SkyHao723/sweeper_chassis/README.md

# sweeper_chassis — 两驱差速清扫车底盘

STM32 底盘控制器 + FOC 驱动器 CAN 总线，上位机是 **RK3588**（ROS 2）。

**只有一个上位机，也只有一个固件。** 定位（卡尔曼滤波）在上位机做，
STM32 只管运动学、CAN 下发、看门狗、继电器和状态上报。

```
┌──────────────┐  USB 115200  ┌────────────────┐  CAN 500k  ┌──────────────┐
│    RK3588    │◄────────────►│     STM32      │◄──────────►│ FOC 驱动器 ×2 │
│  ROS2 + EKF  │  CH340       │  (底盘控制器)   │  PA11/PA12 │  1号 / 2号    │
└──────────────┘  PA9/PA10   └───┬────────┬───┘            └──────────────┘
                                 │        │
                            PB0 ┌▼┐   PB1 ┌▼┐
                                滚刷继电器  水泵继电器

                        PB10/PB11 ── 亚博 YbImu（软件 I2C）
                        PB9       ── 状态灯（上电后 2Hz 闪 = 主循环活着）
```

> 早期用 ESP32 网页遥控当临时上位机调试，**已废弃并从仓库移除**。
> STM32 上对应的 USART2 / 双口控制权仲裁 / 本地 EKF 也一并删掉了。

---

## 目录结构

```
sweeper_chassis/
├── README.md                             本文件
├── docs/
│   ├── wiring.md                         完整接线总表（先看这个）
│   ├── ros-integration.md                接入 ROS 2 的状态/启动/还缺什么
│   ├── ★ nav2-reference.md               **给做 Nav2 定位/导航的同事**：接口契约、
│   │                                     TF 树、实测精度、速度包线、故障模式
│   ├── chassis-serial-protocol.md        底盘串口协议说明（Wheeltec 那套，RK3588↔STM32）
│   ├── ★ foc-can-protocol.md             **FOC 驱动器 CAN 协议（STM32↔驱动器）**，
│   │                                     经厂家资料核对；模式/控制字/回码/上报/故障码
│   ├── pos-mode.md                       位置模式实验（在 pos-mode 分支上）
│   └── foc-driver-protocol-v1.2.pdf      FOC 驱动器通讯协议原始文档（厂家 PDF）
├── tools/
│   ├── decode_diag.py                    解码扩展诊断帧（查"轮子有没有劲"）
│   └── chassis_check.py                  底盘验收（命令值 vs /odom 实测）
└── firmware/
    └── stm32-chassis/                    STM32 底盘控制器（Keil MDK）
        ├── stm32-chassis.uvprojx         ← 唯一的工程
        ├── user/                         main.c / 中断 / 库配置
        ├── hardware/                     外设驱动（YbImu / OLED）
        ├── sys/                          Delay
        ├── lib/  start/  RTE/            ST 标准外设库 / CMSIS
        └── DebugConfig/
```

---

## 分工

| 谁 | 干什么 |
|---|---|
| **STM32** | 解析车体速度 `(vx, vy, wz)` → 差速逆解 → CAN 下发；轮速正解 + 读 IMU → 上报；看门狗；继电器 |
| **RK3588** | 真正的上位机：ROS 2 + EKF + 导航。接 STM32 的 USART1（PA9/PA10）|

**为什么 EKF 不在 STM32 上**：算力放在上位机，换车/改模型只改一处；
STM32 也不必为了滤波去背一堆浮点矩阵。本仓库历史上确实在 STM32 上跑过
EKF（配合网页画轨迹），ESP32 退场时一起删了，需要的话在 git 历史里找。

### ★ 两辆车共用这一份固件（编译期选车型）

底盘控制对两辆车**完全一样**，只有几何不同，所以用 `main.c` 里的一个宏区分：

| | 扫地机 sweeper | 洗地机 scrubber |
|---|---|---|
| 轮径 / 轮距 | 205 mm / 930 mm | **150 mm / 425 mm** |
| 轮周长 | 0.64403 m | 0.47124 m |
| `vx`→单轮RPM | `× 93.03` | `× 127.32` |
| `wz`→单轮RPM | `× 43.26` | `× 27.06` |
| 最大线速(200RPM) | 2.147 m/s | 1.571 m/s |
| PB9 心跳灯 | **2 Hz** | **5 Hz** |

```c
#define VEHICLE_SEL   VEHICLE_SCRUBBER   /* 默认值; 正常走 Keil target 选车型 */
```

**★ 选错是安全级错误**：把扫地机固件烧到洗地机上，转向增益变成
`930/425 = 2.19 倍`（转过头一倍多），而上报的 `body_wz` 只有真值的 `0.457 倍`
（EKF 严重低估转角 → 导航跑飞）。三道防线：

1. `VEHICLE_SEL` 没选或选错 → **直接 `#error` 编译失败**（不会悄悄用默认值）；
2. **PB9 心跳灯频率 = 车型**（2Hz 扫地机 / 5Hz 洗地机），上车前扫一眼；
3. 诊断帧 `f[30]` bit5-6 = 车型号，`decode_diag.py` 印成
   `车型=扫地机205/930` / `车型=洗地机150/425`。

⚠ 洗地机的 `MOTOR1_IS_LEFT` / `MOTOR1_INVERT` / `MOTOR2_INVERT` 是**接线属性**，
现在照抄扫地机的值，**第一次上电必须验证**：`decode_diag.py --drive 0.2 0`，
看两个轮子的"实际"是不是都为正。

---

## 快速开始

### 接线

**先读 [`docs/wiring.md`](docs/wiring.md)**，里面有全部引脚、电源要求和排错顺序。

最容易踩的三个坑：

1. **所有板子必须共地**（继电器不共地会持续嗡嗡响）
2. **串口 TX/RX 要交叉接**（TX 接对方的 RX）
3. **CAN 收发器选 3.3V 的**（SN65HVD230），TJA1050 是 5V 的，直连 PA11 有风险

### 编译烧录 STM32

工程：`firmware/stm32-chassis/stm32-chassis.uvprojx`

**★ 工程里有三个 target，第一个就是"选车型"—— 不用改源码：**

| Keil target | 车型 | 几何 | PB9 心跳灯 | 产出的 hex |
|---|---|---|---|---|
| `sweeper` | 扫地机 | 205 / 930 mm | **2 Hz** | `Objects/sweeper/sweeper.hex` |
| `scrubber` | 洗地机 | 150 / 425 mm | **5 Hz** | `Objects/scrubber/scrubber.hex` |

两个 target 的唯一差别就是编译宏 `-DVEHICLE_SEL=1/2`，源码是同一份。
**每个 target 有自己独立的输出目录**（`Objects/sweeper/` 与 `Objects/scrubber/`）——
这一点是必须的，理由见下面那个坑。

**烧录步骤：**

1. Keil 打开 `stm32-chassis.uvprojx`
2. 工具栏 target 下拉框选 **`sweeper`** 或 **`scrubber`**　← ★ 这一步就是在选车型
3. `F7` 编译（产物落在 `Objects/<车型>/<车型>.hex`，**路径和文件名都自带车型**）
4. ST-Link (SWD) 接上，`F8` Download
5. 烧完**看一眼 PB9 的灯**：2 Hz = 扫地机，5 Hz = 洗地机，对上了再上车
6. 上位机起来后再核一次（最硬的证据）：`python tools/decode_diag.py --port ...`
   看 **车型=** 那一栏是不是 `扫地机205/930`

SWD 占用 PA13/PA14，和串口不冲突。目前 Code ≈ 12972 B / RO 268 / RW 160，
两条 target 都是 **0 Error 0 Warning**。

> ### ★★ 2026-10-12 的坑：烧错固件（已修，务必知道）
>
> **症状**：target 明明选的是 `sweeper`，但 PB9 **灯闪得很快**（= 5 Hz），
> 同事反馈**导航不对**。Keil 编译日志是干净的 0 Error 0 Warning，完全看不出来。
>
> **根因**：加双 target 时是用文本复制 `<Target>` 块做的，把原来的
> `.\Objects\` 一起复制了过去 —— **两个 target 共用同一个输出目录**，
> 而 `.o` 是按**源文件名**命名的，于是**全工程只有一个 `main.o`**。
> 于是这个序列就会出错：
>
> ```
> 选 scrubber -> F7 编译   → main.o 是【洗地机】版
> 选 sweeper  -> F7 增量编译 → Keil 发现 main.c 比 main.o 旧, 不重编
>                            → 直接把洗地机的 main.o 链成 sweeper.hex
> ```
>
> **实测证据**：当时 `Objects/main.o` 时间戳 14:10:45（洗地机那次编译），
> 而 `Objects/sweeper.axf` 是 14:19:17（晚了 9 分钟，中间没重编），
> 且 `sweeper.hex` 与 `scrubber.hex` **SHA256 完全相同**。
> 也就是说 **`sweeper.hex` 里装的确实是洗地机固件** —— 灯没说谎。
>
> **后果**：洗地机的几何（150/425）装到扫地机上 → 转向被放大/缩小 2.19 倍、
> 里程计距离少报 27%（详见下面"两辆车共用这一份固件"那节）→ **导航必然跑飞**。
>
> **修法**：每个 target 一个独立输出目录
> （`Objects/sweeper/` 与 `Objects/scrubber/`，`Listings/` 同理），
> 这样 `.o` 不可能互相覆盖。`tools/add_keil_targets.py` 已同步修好，
> 以后加车型不会再犯。
>
> **教训**：
> 1. **"两个 hex 不一样"不等于"两个 hex 都对"** —— 我上次就是这么验的，
>    当时刚跑完 Rebuild 所以确实对，但**没验证"哪个是哪个"**。
>    真正的验证要在 hex 里搜**车型特有的常量**（扫地机周长 0.644026 / 轮距 0.930，
>    洗地机 0.471239 / 0.425）。
> 2. **换 target 之后如果不用 Rebuild，就一定要看灯**。现在结构上修好了，
>    但"看灯复核"这个习惯值得留着 —— 它是唯一不依赖工具链的行为。

> ⚠ 改双 target **之前**那个 `Objects/stm32-chassis.hex` 已经删掉了 ——
> 它的文件名不带车型，分不清是哪辆车，别再烧它。
>
> `VEHICLE_SEL` 没定义时会落到 `main.c` 里的默认值（现在是洗地机），
> 但**别依赖这个默认值**：命令行直接编、或者以后新加 target 忘了带宏，就会落到
> 它上面。所以正常流程一律走"选 target"。
>
> 命令行编译要**显式带 target**：`UV4 -r stm32-chassis.uvprojx -t scrubber -o log`。
> 不带 `-t` 编的是列表里**第一个**（现在是 `sweeper`），不是源码默认值 —— 别混。
>
> 以后要再加车型（第三个底盘）：`python tools/add_keil_targets.py <uvprojx>`
> （幂等，已经加过会拒绝并提示；会自动给新 target 设独立输出目录）。

---

## 底盘参数

在 `firmware/stm32-chassis/user/main.c` 顶部，**换车必须重新标定**：

```c
#define WHEEL_DIAMETER_MM   205.0f   /* 车轮直径 */
#define TRACK_WIDTH_MM      930.0f   /* 左右轮触地间距 */
#define MAX_RPM             200      /* 单轮转速上限 */

#define MOTOR1_IS_LEFT      1        /* 1号电机在左侧 */
#define MOTOR1_INVERT       0        /* 某个轮子转向相反时改成 1 */
#define MOTOR2_INVERT       1        /* 实测 2 号电机正方向是反的 */

#define ACCEL_STEP_MS       0        /* 加速间隔 ms/1RPM, 0=阶跃, 见下 */
#define DECEL_STEP_MS       0        /* 减速间隔, 停车安全优先, 保持 0 */
```

方向不对照着 `docs/wiring.md` 的校准表改，别硬调混控逻辑。

### 加减速斜坡：现在是 0（阶跃），别再凭直觉加

命令帧里的 `DATA4/DATA5` 是**加减速间隔**，单位是「每变化 1 RPM 花多少毫秒」，
范围 0~100，0 = 阶跃。

**曾经改成 3**（想让起步柔和、少顶过流保护），但一直没做 A/B。后来补上对比，
同一条 0.30 m/s 直线：

| | 斜坡=3 | 斜坡=0（现在）|
|---|---|---|
| 稳态速度 | 68%~137% 乱跑 | **86%**（全程=稳态）|
| 到 80% 速度 | 0.15~0.80 s | 0.40 s |
| 直线漂移 | ~20°/m | **−5.4°/m**（1.54 m 偏 8.3°）|

**漂移改善约 4 倍。** 机理猜测：斜坡让驱动器的设定值缓慢爬升，而驱动器速度环
本身就在低频振荡（空载实测：目标 18 RPM 时实际在 0~22 之间来回冲），设定值
慢慢追会让两者互相激励、振得更厉害；改回阶跃后环反而更容易稳住。

**想再加斜坡之前先做 A/B，别凭直觉**；也别指望它改善准确度 —— 它本来是为了柔顺。
减速也保持 0：要停就立刻停，停车安全优先。

> 起步迟钝的**真正**原因不是斜坡，是轮胎刮擦/静摩擦（见下面"轮速外环修正"）。
> 斜坡只会雪上加霜。

### 轮速外环修正（trim）

STM32 原来是**纯开环**：算完目标轮速直接发给驱动器，从不回读实际转速。所以
驱动器没做到位它也不知道。实测（2026-09，原地转，车在实地）：

| 命令 wz | 单轮目标 | 第 0 秒 | 第 1 秒 | 第 2 秒 | 稳态 | 四秒总角度 |
|---|---|---|---|---|---|---|
| 0.30 | 13 RPM | 5% | 15% | 89% | 85% | 49% |
| 0.50 | 22 RPM | 1% | 29% | 20% | 115% | 41% |
| 0.70 | 30 RPM | 10% | 86% | 121% | 106% | 81% |
| 1.00 | **43 RPM** | **26%** | 106% | 100% | 96% | 82% |

**即使目标高达 43 RPM，第 0 秒也只有 26%** —— 而直线运动 0.07 秒就到 80%。
同一个轮速区间差这么多，说明这**不是**驱动器低速死区，而是**原地转要克服轮胎
刮擦/静摩擦**：轮子是真的没转（不是空转打滑），所以把指令顶上去它就会转。

#### 第一版：纯积分 + 绝对限幅（已废弃，别重犯）

第一版是"纯积分 + 绝对限幅 ±30 RPM + `TRIM_KI=1.5`"。四秒总角度确实从
41%~82% 提到了 85%~98%，稳态也从 115% 回到 101% —— **但形状和安全性都不合格**：

- **绝对限幅在小名义值下会把指令顶成反向。** 原地转 `wz=0.30` 的名义轮速只有
  13 RPM，而修正量能到 -30，于是 `指令 = 13-30 = -17`，**轮子反转**。干净重测的
  逐秒数据 `0.025 / 0.585 / 0.573 / -0.001` 里第 3 秒直接归零，就是它。
  一个"修正"把自己修成了故障。
- **`TRIM_KI=1.5` 太快，和驱动器那个环组成了慢速极限环。** `wz=1.00` 的逐秒是
  `0.386 / 1.746 / 0.867 / 0.529`：第 1 秒过冲 175%，然后一路衰减下去。
  积分增益 × 被控对象滞后 > 1 就会这样。
- 第一版注释里写的"输出永远落在普通全速命令能到的范围内"是**错的**：
  `MAX_RPM` 是 200，而 ±30 的绝对限幅在名义值 13 时已经把指令推到 2~3 倍了。

#### 第二版：慢积分 + 比例限幅 + 定时助推（已废弃）

```c
#define TRIM_KI            0.6f     /* 慢积分, 只修稳态偏差 */
#define TRIM_UP_K          0.5f     /* 正向最多 +50% 名义值 */
#define TRIM_DOWN_K        0.5f     /* 反向最多 -50% 名义值 -> 永不反转 */
#define KICK_RPM           12.0f    /* 起步助推幅度, 固定值 */
#define KICK_MS            400      /* 助推的硬上限时长 */
#define KICK_RELEASE_K     0.6f     /* 轮速达到名义值的这个比例就撤掉助推 */
```

三条改动逐条对症：

1. **限幅改成按名义值的比例**，不用绝对值 —— 于是指令永远落在 `[0.5, 1.5]` 倍
   名义值之内，**方向永远不变**。反转从机制上被消除。
2. **`TRIM_KI` 降到 0.6**，让它只修稳态偏差，不去和驱动器那个环抢动态。
3. **起步助推单独做。** 突破静摩擦需要的是"立刻给力"，而积分天生要"等误差攒
   起来"；把积分调到能立刻给力，它就会在轮子追上来之后迟迟不回，那正是第一版的
   过冲。两件事分开：**积分慢而稳只管稳态，助推开环/有界只管起步这一下**
   —— 开环所以不构成第二个反馈回路，也就不会振。

第二版的助推判据是"轮速一到名义值的 60% 就撤"（`KICK_RELEASE_K`），比第一版的
纯定时好，但仍然**按名义值的比例**判定 —— 这就是它后来又出问题的原因（见第四版）。

#### 第三版：加线性带（已并入第四版）

第二版实测逐帧抓到：**积分在起步暂态里把自己顶到限幅**，然后和驱动器的 PI 组成
一个 **0.25 Hz 的极限环** —— `目标-理论` 那一列直接看得到:
`+7 -> +13(贴住限幅) -> +12 -> +9 -> +5 -> 0`，来回摆 ±14 RPM，周期 4~5 秒，
和速度振荡测出来的 0.25 Hz 完全吻合。机制：起步时轮子没转 → 误差巨大 → 积分顶到
+50% → 驱动器本来就过冲 → 实际冲到 186% → 误差大幅反向 → 积分慢慢退回甚至摆到
-50% → 车慢下来 → 积分又上去。

所以加了**线性带**：**误差超过 `TRIM_LIN_BAND_RPM` 就不积分**。起步/被刮擦卡住时
误差是 20~28 RPM，落在带外 → 完全不积分 → 从根上消掉那个 windup。同时 `TRIM_KI`
0.6→0.3、权限 ±50%→±20%。改完后 `目标-理论` 平在 ±1 RPM。

#### 第四版（现在）：绝对转速判据 + 按缺口给量 + 给不动就加力

实车又报了两个症状 —— **它们是同一个根因的两端**：

| 症状 | 根因 |
|---|---|
| 发小一点的转向命令，车愣在原地 | 助推是 **400 ms 一次性定时**，超时就撤，且目标没回零就**不会重新武装** |
| 转向太敏感 | 助推是**固定 +12 RPM 加性**，原地转时等效 **+0.28 rad/s**；每次起步都给满 400 ms |

```c
#define TRIM_ENABLE        1
#define TRIM_KI            0.3f     /* 慢积分, 只修稳态偏差 */
#define TRIM_UP_K          0.2f     /* 正向最多 +20% 名义值 */
#define TRIM_DOWN_K        0.2f     /* 反向最多 -20% 名义值 -> 永不反转 */
#define TRIM_MAX_RPM       20.0f    /* 绝对上限, 防高名义值下修正量过大 */
#define TRIM_LIN_BAND_RPM  5.0f     /* 误差超过它就不积分 */
#define TRIM_DEADBAND_RPM  0.5f     /* 目标小于它 = 不该动, 全部清零 */

#define KICK_BASE_RPM      15.0f    /* 起步门槛估计: 助推把命令补到这个轮速 */
#define KICK_MAX_RPM       20.0f    /* 助推上限(含逐级加力) */
#define KICK_STEP_RPM      4.0f     /* 给不动 -> 每 KICK_STEP_MS 再加这么多 */
#define KICK_STEP_MS       200
#define KICK_STILL_RPM     2.0f     /* |实际| 低于它 = 还是静止 */
#define KICK_MOVING_RPM    6.0f     /* |实际| 高于它 = 转起来了, 撤助推 */
#define KICK_MAX_MS        3000     /* 加到上限还不动, 先给这么久就歇一下(防卡死) */
#define KICK_COOL_MS       2000     /* 歇多久再试(★ 不能永久放弃, 见下) */
```

三条：

1. **判"动没动"用绝对转速**（`KICK_STILL_RPM` / `KICK_MOVING_RPM`），不看名义值的
   比例。要破的是静摩擦，"轮子转没转"跟命令多大无关。副产物：判据与命令大小
   无关，大命令上不会过度助推，也不会在阈值附近抖。
2. **按缺口给量**：`助推 = clamp(KICK_BASE_RPM - 最小|名义轮速|, 0, KICK_MAX_RPM)`。
   名义值本身就超过起步门槛 → 助推 = 0 → **正常行驶完全没有助推**：
   直行 0.30 m/s（名义 27.9 RPM）助推 0，原地转 `wz ≥ 0.35` 助推 0。
   小命令则被**恰好**补到起步门槛，不多给。
3. **给不动就逐级加力**：补到 15 还不动，每 200 ms 再加 4 RPM，到 20 封顶。
   这样"到底要多大劲才动得起来"是**实测量出来的**，`KICK_BASE_RPM` 只是起点。

为什么固定 +12 RPM 对偏航的影响被严重低估 —— 助推是**按各自名义方向**加的
（右轮 +12、左轮 -12），换算成偏航角速率（`每轮名义 RPM = wz × 43.26`）：

```
Δwz = 助推 / 43.26        12 / 43.26 = 0.28 rad/s
```

也就是原地转**起步那段时间真实 wz 比命令值高 0.28 rad/s**：`wz=0.30` 的实际是
0.58（192%），`wz=0.50` 的实际是 0.78（155%）。**这解释了为什么稳态测出来是
100~102% 却仍然手感"贼"** —— 助推是暂态，稳态数据里看不到它，人每次起步都能感到。

**助推对 `(vx, wz)` 的影响取决于两轮名义值同号还是异号**（很容易想错）：

| 情况 | 助推的效果 |
|---|---|
| **原地转**（`vx=0`，两轮名义值异号） | 两轮被往相反方向推 → 差分增加值 `2×助推` → **偏航被抬高**，`Δwz = 助推/43.26` |
| **边走边转**（`vx` 够大，两轮名义值同号） | 两轮加的是**同一个方向** → 差分**不变** → **偏航一点没变**，只是车临时多往前冲一点 |

所以"转向变敏感"只可能来自**原地转**；边走边转时 `wz` 是诚实的。第四版把
`|wz| ≥ 0.35` 的助推压到 0，正好把原地转这个来源切掉。

**助推必须是两轮共享的一次判决**（`Boost_Decide()`）。若按各自转速独立判决，
转弯/起步时总有一个轮子先转起来、先撤掉助推，另一个还在加 → 两轮指令瞬间差
十几 RPM → **起步时车会歪一下**。旧版是固定 400 ms 定时，两边同时给同时撤，
天然对称；改成"没转起来就给"之后必须显式做成共享，否则等于凭空引入一个偏航源。

**安全性**（按"绝不引入新的失控模式"设计）：

1. 指令永远落在 `[1-TRIM_DOWN_K, 1+TRIM_UP_K]` 倍名义值之内（助推另加，且助推
   有上限 `KICK_MAX_RPM`），**方向不变**。
2. **目标为 0 时 `Trim_Apply` / `Boost_Decide` 恒定返回 0**，修正和助推一起清零、
   不留历史 —— 外环**不可能**在主机下令停车的时候把车带着走。这是敢上车的底线。
3. 最后还有一条独立的保险：名义为正就保证输出 ≥ 0，反之亦然。即使上面的限幅
   哪天被人改错，这条也能兜住。
4. 驱动器回码不新鲜时不积分、只保持，助推也**倾向于不撤**（没观测就不做结论）。
5. **里程计不受影响**：`Wheel_Update()` 用的仍是驱动器回传的实际转速，外环只改
   下发值，所以上报给上位机的轮速依然诚实。
6. 积分用的是**真实周期**（从 `g_tick_ms` 算），不是标称的 20 ms —— 否则
   `TRIM_KI` 的实际含义会随主循环负载漂移，参数就没法标定了。
7. **防卡死**：助推加到上限还不动满 `KICK_MAX_MS` 就**歇 `KICK_COOL_MS`**（3 s 给 /
   2 s 歇的占空比），免得一直顶着烤电机和驱动器；同时把诊断帧 `flags` **bit7**
   置位（锁存到目标归零）。★ 这里**刻意不做成"永久放弃"** —— 第一版的毛病就是
   "超时之后再也不给"，于是小命令永远愣在原地；万一这台车破静摩擦真的需要比
   `KICK_MAX_RPM` 更大的劲，一次放弃就等于把那个故障原样造回来。

**怎么看它在不在干活**：诊断帧里上报的"目标"是**含修正和助推的最终命令**。用
`--drive` 时脚本知道主机下发的理论目标，会自动把差值还原出来：

```bash
# ★ 跑之前必须先暂停看门狗! 否则它会把 ROS 节点反复拉回来抢串口（见"已知的坑"）
touch /tmp/chassis_watchdog.pause
# 然后停掉 ROS 底盘栈 (Ctrl-C), 再:
python3 tools/decode_diag.py -p /dev/wheeltec_controller --drive 0 0.5
# 输出里会多出一段:   目标-理论+18/+25(含助推)
rm /tmp/chassis_watchdog.pause     # 调完一定要删!
```

> ⚠️ 那个"目标-理论"是 **积分修正 + 助推** 的合计，不是积分本身。实测被它骗过
> 一次：看到 `+13` 以为积分已经顶到比例限幅了，其实其中 12 是助推、积分只剩 1。
> **诊断帧没有空余字节放助推量**，所以固件在 `flags` 上给了两个位：
> **bit6 = 这一帧正在给助推**，**bit7 = 加到上限还不转**。`decode_diag.py` 会把
> 它们翻成中文打出来。

**调参**：起步还是慢/还是愣 → 加 `KICK_BASE_RPM`（每次 +3 RPM 试）。
嫌起步窜 → 减 `KICK_BASE_RPM`。看到轮速以 0.1~0.2 Hz 慢速来回摆 → 降 `TRIM_KI`。
想 A/B 就把 `TRIM_ENABLE` 改成 0 重新编译（两条路径都能 0 Error 0 Warning 通过）。

**这次改动怎么验证**（★ 未上车，先按这个顺序做）：

```bash
# 0) 暂停看门狗, 停掉 ROS 底盘栈
touch /tmp/chassis_watchdog.pause

# 1) 小命令不再愣住: wz=0.25 原地转, 看"实际"能不能离开 0
python3 tools/decode_diag.py -p /dev/wheeltec_controller --drive 0 0.25
#    期望: flags 出现"起步助推中", 实际轮速 1~2 秒内起来, 然后助推自动消失

# 2) 正常转弯不再窜: wz=0.5 原地转, 期望 flags **不出现**"起步助推中"
python3 tools/turn_truth.py 0.5
#    期望: 对 IMU 真值 100% 左右, 且起步段不再明显超前

# 3) 直行起步: 助推应为 0(名义 27.9 RPM > 门槛 15), 起步过冲应比旧版小
python3 tools/straight_quality.py 0.30 10
#    ★ 这是最需要确认的一条: 旧版靠 +12 RPM 起步, 现在直行不给助推了,
#      万一 27.9 RPM 自己起不来, 就会看到"命令有、实际 0" -> 那就把
#      KICK_BASE_RPM 调大(比如 20), 让它对直行也稍微补一点

# 4) 收工
rm /tmp/chassis_watchdog.pause
```

#### 还没解决：直线精度的锅不在外环，在驱动器自己的速度环

> 下面这组数据是**第一版/第二版助推时代**抓的（那时助推固定 +12 RPM，所以
> "目标 +35" = 名义 27.9 + 助推 7）。第四版的助推在直行上已经是 0，但驱动器
> 速度环自己那个极限环是**下面这个结论**，和外环无关，仍然需要重测确认。

用 `decode_diag --drive 0.30 0` 逐帧看（这是唯一能看到外环内部的途径）：

```
目标 +35  实际  +0   +7.80A     ← 目标是名义值 27.9 + 助推
目标 +36  实际 +62   +5.00A     ← 实际跳到名义值的 2.2 倍
目标 +41  实际 +23   +8.00A
目标 +31  实际 +52   +1.60A
```

**目标 27.9 RPM，实际在 0 ↔ 71 RPM 之间暴力来回冲，电流 7~11A。**

而外环自己只贡献几个 RPM。所以**直线精度的根因是驱动器速度环自己的极限环**，
这一层外环够不着 —— 外环只能改"要它转多快"，改不了"它内部怎么调"。

这也解释了 `chassis_check.py` 报的"全程 31% 而稳态 106%"：不是自相矛盾，是
速度在剧烈振荡，而"稳态"只取尾部 40%，恰好采到了波峰。

**能治它的只有两条路**（也就是本文档早先那句"要么找厂家调，要么在 STM32 上用
扭矩模式自己做速度环"）：
1. 找厂家调 / 关掉驱动器内部的速度环参数 —— 协议不暴露这些寄存器。
   **2026-10-11 已用厂家资料核实过，确认没有任何参数读写通路**
   （CAN/串口/BLE 都没有，见 [`docs/foc-can-protocol.md`](docs/foc-can-protocol.md) §6），
   所以这条路**只能找厂家**，我们调不了。
2. **STM32 切扭矩模式，自己做速度环。** FOC 的扭矩指令是平滑的，这样也不再有
   第二个环跟它打架。代价是安全性模型变了：**扭矩模式下"指令卡住"= 持续加速**
   （速度模式只是匀速跑），必须配电流限幅，并依赖 IWDG + 上电刹车帧兜底。
   ★ **这条路现在是通的**：核实确认**扭矩模式 `0x04` 确实存在**
   （单位 A、量程 ±10.0 A、值 = 电流×10），我们之前"0x04 不存在"的判断是**错的** ——
   详情与出处见 [`docs/foc-can-protocol.md`](docs/foc-can-protocol.md) §2.1 与 §7。
   ⚠️ 但它在**我们这台**驱动器上能否动作仍是 ❓ 未实测。

---

## 状态上报

STM32 每 50ms 往 USART1 发**两帧**：

| 帧 | 长度 | 内容 |
|---|---|---|
| 主遥测帧 `0x7B` | 24 字节 | 标准 Wheeltec 格式：车体 vx/vy/wz、IMU 六轴、电池电压 |
| 扩展诊断帧 `0x7E` | 36 字节 | 本工程自定义：**每路驱动器的最终命令/实际转速、输出电流、故障码、模式** |

帧顺序**不能反**：主遥测在前、诊断帧紧跟，诊断帧永远夹在两个 24 字节帧之间。

**为什么厂商节点不会被这一帧干扰**：它的入帧条件是「上一字节是帧尾 `0x7D`
（或 `0x7F`）、本字节是帧头 `0x7B`」。诊断帧自己的帧头是 `0x7E`、帧尾是 `0x7D`，
所以它会被整帧跳过，紧接着的那个 `0x7B` 恰好满足入帧条件 —— 24 字节帧一帧都不丢，
**厂商侧不需要任何改动**。

### 怎么读诊断帧

```bash
# 串口是独占的: 先把厂商底盘节点停掉 (Ctrl-C), 看完再起回来
python3 tools/decode_diag.py -p /dev/wheeltec_controller

# 只看有问题的轮子
python3 tools/decode_diag.py -p /dev/wheeltec_controller --only-problems
```

输出长这样：

```
seq=3   vx= +145 wz=   +0 | 1号 目标 +28 实际  +0  +0.02A 速度   正常   | 2号 目标 +28 实际 +28  +1.75A 速度   正常
    !! 1号 命令 +28 RPM 但实际 +0 RPM 且电流仅 0.02A -> 驱动器没给力(查故障码/使能/接线)
```

**输出电流是判断「这个轮子到底有没有劲」唯一的客观指标**，它把两种情况分开了：

| 现象 | 含义 |
|---|---|
| 目标有转速、实际不转、**电流≈0** | 驱动器根本没给力 → 查故障码 / 使能 / 接线 |
| 目标有转速、实际不转、**电流很大** | 给了力但被堵住或拖住 → 查机械卡滞 / 负载 |
| 目标有转速、实际也有、电流正常 | 正常 |

故障码表来自 `docs/foc-driver-protocol-v1.2.pdf` 第 11 页，脚本里已经内置：

```
0 正常   1 驱动器故障   5 过流   6 过压   7 欠压   8 过温
23/24 电机2/1 霍尔故障   25/26 电机2/1 堵转
27 UART 故障   28 RS485 故障   29 CAN 故障
```

> **7 = 欠压值得特别注意**：车上电池实测 26.6V 左右，而电机是 36V 额定的，
> 加速时电池一压降就可能触发欠压保护，表现正是「这个轮子突然没劲了」。

### 台架复验（轮子必须悬空）

串口是独占的，所以「下令」和「看数据」不能分成两个程序。`--drive` 让脚本
一边下发命令一边解码：

```bash
# 1. 停掉厂商底盘节点 (Ctrl-C)，否则串口抢不到
# 2. 轮子架空，按顺序跑这几条，每条都用 Ctrl-C 或 --seconds 结束
python3 tools/decode_diag.py -p /dev/wheeltec_controller --drive 0.10 0 --seconds 3
python3 tools/decode_diag.py -p /dev/wheeltec_controller --drive 0 0.30 --seconds 3
python3 tools/decode_diag.py -p /dev/wheeltec_controller --drive 0 -0.30 --seconds 3
```

看什么：

| 现象 | 结论 |
|---|---|
| 两个轮子都转、电流都是正数、方向对 | 正常，可以上地面 |
| 某一路 `实际` 始终 0 且 `故障` 非 0 | 驱动器报故障，按故障码查 |
| 某一路 `实际` 始终 0、`故障`=0、**电流≈0** | 驱动器没给力 → 先查驱动器使能、功率电、CAN 接线（**和继电器无关**，继电器只管滚刷/水泵）|
| 某一路 `实际` 始终 0、`故障`=0、**电流很大** | 给了力被堵住 → 查机械卡滞 |
| 原地转向时两轮 `目标` 一正一负 | **正常**，差速车原地转就是这样 |

脚本退出时会自动连发一串零速把车按住。STM32 另有 800ms 看门狗兜底。

### ★ 指令保活：不发就会停（和"记住最后一条命令"的车不一样）

**本车不会保持最后一条命令。** 800 ms 收不到**速度帧**，STM32 就把目标归零并刹车，
而且**锁存**（诊断帧 `flags` bit1 `看门狗停车`，下一条速度帧才解除）。代码在
`main.c` 的 `LINK_TIMEOUT_MS` 那一段。

所以：**发一条 `vx=0.5` 然后不再发 → 车走约 0.8 秒就停**，不会一直走。
以前那种"发一次就一直走"的车是底盘记住了最后一条命令，那是另一套设计（也更危险：
上位机进程死了车还在跑）。

配套推论：**任何发布 `/cmd_vel` 的节点都必须持续发，频率要 ≥ 2 Hz。**
Nav2 的 `controller_server` 按控制频率发（默认 20 Hz），没问题；
但自己写的脚本发一条就退出，车只会动 0.8 秒。

**零速命令是"一等公民"，不会被当成没命令。** 收到 `vx=0, wz=0` 的速度帧时，
STM32 会：喂运动看门狗、**把 `failsafe_latched`（`flags` bit1）清掉**、然后按
20 ms 周期发 `CTRL_BRAKE` 刹车帧。所以：

| | 收到零速帧 | 静默 800 ms |
|---|---|---|
| 电机动作 | 刹车帧 @20 Hz | 刹车帧 @20 Hz |
| `flags` bit1 看门狗停车 | **清 0** | **置 1 并锁存** |
| 滚刷/水泵 | 保持 | 断开 |

也就是说"显式停车"和"上位机掉线"**在电机上一样、在语义上完全不同**，
而且**发零速帧还能把上一次的锁存解除掉**（想让车老实停住，就持续发零速）。
单个零速帧长这样（BCC 恰好等于帧头）：

```
7B 00 00 00 00 00 00 00 00 7B 7D
```

> ⚠️ 但有个陷阱：如果 `/chassis_security` 或 `/robot_recharge_flag` 被置成非 0，
> 厂商节点会把这两个标志塞进每条速度帧的 `f[1]`/`f[2]`，STM32 就会把**所有**
> 速度帧（包括零速）当成功能帧丢掉 —— 表现为 `/cmd_vel` 在发、遥测正常、**车
> 完全不动**，而且 800 ms 后 `flags` bit1 会置位。详见
> [chassis-serial-protocol.md 6.3.1](docs/chassis-serial-protocol.md)。

**★ 用键盘 teleop 会因此变得很难开，这是实测过的坑：**

车上装的 `teleop_twist_keyboard` 2.4.1 在 Linux 下是**阻塞**读一个字符
（`sys.stdin.read(1)`，**没有超时**），而且**每按一次键只发一条 Twist**：

- 默认步长 `speed=0.5 m/s`、`turn=1.0 rad/s`，是**绝对值**不是增量。
- 按一次 `i` = **发一条** 0.5 m/s 的消息 → 只够走 0.8 秒 → 看门狗把车停住。
- 想连续走必须**按住键**（靠终端按键重复）。一松手，0.8 秒后车就停。
- 而 0.5 m/s 正好落在**实测不该用的区间**（实测 134% → 实际约 0.67 m/s）。

一边要不停按键、一边每条命令还都超出工作包线，手感自然"非常不好控制"。
**换成网页遥操就好**（见下一节）：它以 20 Hz 持续发布同一条命令，
所以手感回到"按住就一直走"，同时真正的死手还在（进程被杀 → 0.8 秒 → 停）。

非要用键盘的话，把步长调下来并按住键：

```bash
ros2 run teleop_twist_keyboard teleop_twist_keyboard \
  --ros-args -p speed:=0.1 -p turn:=0.3
```

---

## 数据网页 + 运动控制（局域网直接开）

车上的 RK3588 跑了一个网页，浏览器打开即可：

```
http://192.168.5.17:8080
```

```bash
# 它是个 systemd 服务, 已 enable, 开机自启
systemctl status chassis-web
sudo systemctl restart chassis-web
journalctl -u chassis-web -f

# 想只要监视、绝对不给任何发速度的可能:
#   改 /etc/systemd/system/chassis-web.service 的 ExecStart 加 --no-control
# 想安全地改控制代码(逻辑全跑但车不动): 加 --dry-run (速度发到 /cmd_vel_dryrun)
```

**首页主角是两个数**，因为这一路查下来真正有信息量的就这两个：

| | 含义 | 为什么要摆在最显眼处 |
|---|---|---|
| **达成率** | `/odom` 实测车体速度 ÷ `/cmd_vel` 命令速度 | 直接回答"车有没有照我说的做"。原地转只到 41%、直线的锅在驱动器内环 —— 都是它先露出来的 |
| **航向差（相对打开页面时）** | (Δ EKF 偏航) − (Δ 轮速偏航) | 回答"EKF 到底有没有在纠偏"。两者几乎重合 = IMU 没起作用 |

其余：命令/实测/融合三路速度对比表、IMU 六轴、电池、6 路超声波、各话题频率与
"最后收到多久"（看 CH340 掉线很有用）、前进/转向滚动曲线、俯视轨迹图。

### 运动控制是照"绝不允许'浏览器不发了车还在走'"设计的

这台车因为控制层的 bug 真失控过一次，而网页遥控最容易出的就是那一类问题
（切标签页、WiFi 断、手指离开、笔记本合盖）。所以：

**三层兜底，任何一层单独失效车都会停：**

| 层 | 触发 | 动作 |
|---|---|---|
| 浏览器 | 松手 / 鼠标移出 / 松开按键 / 切标签页 / 失焦 / 空格 / 急停键 | 立刻 POST 停车 |
| **服务端** | 浏览器 **0.5 s** 没发心跳 | 立刻**补发 8 帧零速**(≈0.4 s) 再闭嘴 |
| STM32 | 0.8 s 收不到速度帧 | 运动看门狗停车 |

> 中间那层的"**补发**"是必须的，不是保险起见：如果只是沉默，STM32 要等它自己
> 800 ms 看门狗才停 —— **那 0.8 秒车还在按最后一条命令走**。这是死手设计里最容易
> 漏的一条缝，已用 `--dry-run` 实测验证过（见下面"怎么验的"）。

**另外四条同样是刻意的：**

1. **必须显式"使能"**（默认禁止运动），丢失心跳不会自动使能。
2. **限幅在服务端做，不信浏览器。** 默认 `vx ≤ 0.35 m/s`、`wz ≤ 1.2 rad/s`
   （实测工作包线 0.25~0.35 最好，>0.4 会超速）。界面上改不了上限。
3. **看不到车就不许动。** `/odom` 超过 1 s 没更新一律停车 —— 底盘链路断了
   （CH340 掉线那种）时你的操作没有反馈，那就不该动。
4. **不主动霸占 `/cmd_vel`。** 只在"使能 + 心跳新鲜"时发布；松开补几帧就闭嘴。
   否则本页 20 Hz 的零速会和 Nav2 抢 `/cmd_vel`，车会一抖一抖。页面还会显示
   `/cmd_vel` 上有没有**别的**发布者并报警。

**急停和松手是两回事**：松手/松键只是**停**（保持使能，不然开车要一直重新点）；
急停键/空格/切标签页是**停 + 撤销使能**。

### 一个刻意的取舍

**只用标准库，不装任何包。** 板子上没有 flask，装包要么 apt 要么 pip，都可能
和 ROS 的 python 环境打架（这台车已经因为环境问题绕过好几次）。
`http.server` + `json` 足够，两个文件（`.py` + `.html`）就能跑。

**两个量都踩过坑，所以页面里写死了防错：**

- **航向差不能用绝对差。** 两路位姿的**原点本来就不一样**（各自从自己的初始位姿
  起算），实测 `/odom` 偏航 −3.03 rad 而 `/odom_combined` −0.005 rad，绝对差
  **173°** —— 看着像出了大问题，其实只是坐标系不同。**一个没有意义的数摆在首页，
  比不摆更糟**，所以服务端干脆不输出它，由前端拿历史里两列偏航算变化量。
- **车停着时相对漂移必然是 0**，那不代表"IMU 没起作用"。所以页面先看这 10 秒里车
  有没有真的动过（路程 > 0.3 m 或转过 > 8°），没动就显示"这个数先不算"而不下结论。

### 导出前 30 秒的逐帧数据（CSV）

页面右上角那个 **「导出前 30 s（CSV）」** 按钮，或者直接开
`http://192.168.5.17:8080/api/export.csv`。文件名带时间戳
（`chassis_20260921_205022.csv`），双击进 Excel / WPS / LibreOffice。

**23 列，20 Hz，600 行 ≈ 正好 30 秒**（服务端滚动缓冲的上限）：

| 组 | 列 |
|---|---|
| 时间 | 时间(s) |
| 前进 | 命令vx · 轮速vx · EKFvx · **前进达成率(%)** |
| 转向 | 命令wz · 轮速wz · EKFwz · **转向达成率(%)** |
| 位姿 | 轮速x/y/偏航(deg) · EKFx/y/偏航(deg) · **航向差(deg 相对本表首行)** |
| IMU | 陀螺x/y/z · 加速度x/y/z |
| 电源 | 电池(V) |

几个刻意的选择：

- **CSV + UTF-8 BOM，不是 xlsx。** `.csv` 不用装任何库就能双击进 Excel；而
  **BOM 一个字节都不能省** —— 不带的话 Windows 版 Excel 会按本地代码页解，
  中文表头直接变乱码。行尾用 CRLF，也是给 Excel 面子。
- **命令相关的 4 列在没人发 `/cmd_vel` 时是空的，不填 0。** 空和"命令是 0"是两回事，
  填 0 会让人以为当时真的在下发零速。
- **达成率列在命令太小时也是空的**（阈值 vx 0.02 / wz 0.05）—— 否则会刷出一堆
  除零出来的假数。
- **航向差是"相对本表首行"**，不是相对某个绝对原点（理由同上面那条：两路位姿原点
  本来就不同）。
- **IMU 是"这一帧 /odom 到达时最新的值"，电池是采样保持**（它只有 ~1.8 Hz）。
  列名里都标了单位，但没标这两个取样口径 —— 拿去做频谱分析前要知道这一点。

> ⚠ 导出的是**当前缓冲区**里有多少就多少，不是"永久全部"。刚重启时可能只有几秒。
> 页面右上角会显示 `缓冲 30.0 s / 600 帧`，导出前先看一眼。

### 怎么验的：`--dry-run` + 一套自动断言

运动控制这种东西**不能靠"点一下看看动不动"来验** —— 那样验不出"心跳断了会不会
补刹车"这类真正要命的分支。所以：

```bash
bash ~/chassis_tools/run_drytest.sh     # 逻辑全跑, 真车一动不动
```

它起一个 `--dry-run` 实例（速度发到 `/cmd_vel_dryrun`），然后断言七件事：
没使能发速度必须被拒且零字节发出、超限必须被服务端夹住、心跳停了必须**补发**刹车、
补发完必须闭嘴、急停必须撤使能、导出 CSV 的 BOM/行尾/**列对齐**。全部通过才算数。

> 三件在这一步踩到的坑，值得记：
> 1. **测试必须确认自己连的是哪份代码。** 有一次旧实例没杀干净还占着端口，新实例
>    `Address already in use` 当场崩掉，**测试连上了跑旧代码的实例**，报了一堆假
>    FAIL。现在 payload 里带 `build` 标记，测试第一步先断言它。
> 2. **`os._exit()` 不会 flush 缓冲区。** 输出是管道（非 tty）时 Python 用块缓冲，
>    结果整份测试输出被吞掉、看起来像"什么都没跑"（这个坑在其它工具里也踩过）。
> 3. **CSV 字段必须按规范转义。** 表头里写了 `航向差(deg,相对本表首行)`，那个逗号
>    把**表头切成了 24 列而数据是 23 列**，整张表从第 16 列开始错位一格 ——
>    Excel 里列名和数据对不上，而且**不报错**，很容易当成数据本身有问题。
>    现在字段转义 + 表头去掉逗号，双保险；断言也改成用 `csv` 模块解析，
>    不再自己 `split(",")`（自己拆就抓不到这个 bug）。

**网页看不到扩展诊断帧**（轮速目标/实际、驱动器电流、故障码、继电器状态）—— 那
一帧在串口上，而串口被 `wheeltec_robot_node` 独占、厂商节点也不解析它。想在网页里
显示，得先给厂商节点加解析+转发（和加 `/chassis_relay` 是同一套做法）。这是明确的
下一步，不是"忘了"。

---

## RK3588 侧的准备

> **完整说明见 [`docs/ros-integration.md`](docs/ros-integration.md)** —— 启动命令、
> 验证过的状态、车型配置、传感器安装位置怎么改、还缺什么，都在那里。
> 这里只留最关键的一条。

底盘通过 **CH340 (`1a86:7523`)** 接 RK3588 的 USB。厂家的 udev 规则只认
CP2102 (`10c4:ea60`) 和 CH343 (`1a86:55d4`)，**不认普通 CH340**，
所以要自己加一条（已经加在车上那台 RK3588 上了）：

```udev
# /etc/udev/rules.d/wheeltec_controller_ch340.rules
KERNEL=="ttyUSB*", ATTRS{idVendor}=="1a86", ATTRS{idProduct}=="7523", \
  MODE:="0777", GROUP:="dialout", SYMLINK+="wheeltec_controller"
```

生效后 `/dev/wheeltec_controller -> ttyUSB*`，厂商的 launch 文件不用改。

#### 为什么必须自己写这条规则（"芯片 ID"）

"芯片 ID"就是 **USB 的 VID:PID**（厂商 ID:产品 ID）。厂商那套 udev 规则是靠
**序列号**认设备的，而**普通 CH340 没有唯一序列号** —— 实测它的 USB 属性是：

```
ID_VENDOR_ID=1a86   ID_MODEL_ID=7523          # CH340 (沁恒/WCH)
ID_SERIAL=1a86_USB_Serial                     # ★ 所有普通 CH340 都是这个字符串
```

对比厂商支持的那两种（**有**唯一序列号，所以厂商规则能按 `serial` 区分）：

| 芯片 | VID:PID | 序列号 | 厂商规则认得吗 |
|---|---|---|---|
| CP2102 | `10c4:ea60` | `0001`~`0005` | ✅ 按 `ATTRS{serial}` |
| CH343 | `1a86:55d4` | `0001`~`0005` | ✅ 按 `ATTRS{serial}` |
| **CH340（本车）** | **`1a86:7523`** | **无（同一个串）** | ❌ **必须按 VID:PID 自己写** |

⚠ **两个隐患，别踩：**

1. **`1a86:7523` 认不出"哪一个" CH340。** 现在车上只插了一个，所以能工作。
   但**我们现在有两辆车，就是两个一模一样的 CH340** —— 同时插到同一台
   RK3588 上（或者插拔换车）时，`/dev/wheeltec_controller` 会指向**最后枚举的
   那一个**，也就是**可能给错的车发指令**。正确做法是按**USB 物理口**钉死：

   ```udev
   # 按物理口区分(CH340 没有序列号可用, 只能这样)。
   # 车上的底盘 CH340 在 usb1 的 1-1 口(直插 RK3588, 不经 hub)。
   KERNEL=="ttyUSB*", KERNELS=="1-1", ATTRS{idVendor}=="1a86", \
     ATTRS{idProduct}=="7523", MODE:="0777", GROUP:="dialout", \
     SYMLINK+="wheeltec_controller"
   ```
   物理口用 `udevadm info -a -n /dev/ttyUSBx | grep -m2 'KERNELS=='` 查；
   或者 `bash tools/check_usbserial.sh` 一次看全。

2. **同一个软链接有 4 条规则在抢**（实测）：
   `wheeltec_controller_ch340.rules`(CH340)、`wheeltec_controller.rules`(CP2102
   serial=0002)、`wheeltec_controller2.rules`(CH343 ttyCH343USB serial=0002)、
   `wheeltec_controller3.rules`(CH343 ttyACM serial=0002)。
   现在只插了 CH340，所以只有第一条命中；**一旦插上带 `serial=0002` 的
   CP2102/CH343，两边的规则都会触发，软链接归谁就不确定了。**
   不用的话把多余那几条删掉/改后缀禁掉最省事。

#### 要不要换成 CH343 + 烧自定义序列号？（同事提过）

CH343 有**可烧写的序列号**，所以能像厂商那两种芯片一样按 `ATTRS{serial}` 认设备，
不依赖物理口。**这确实是"正确"的做法** —— 厂商自己的规则就是按 CH343 + serial
写的。但**本车现在换不了**，实测：

```
ch341.ko 的 alias 一共 6 个, 里面**没有 55d4**
  usb:v1A86p7523d* / v1A86p7522d* / v1A86p5523d* / v9986p7523d* / v4348p5523d* / v2184p0057d*
/lib/modules/6.1.118 里只有 ch341.ko, **没有 ch343.ko**, 也没有 dkms
当前 tty: 只有 /dev/ttyUSB10 (没有 ttyCH343USB*, 没有 ttyACM*)
```

也就是说：**内核自带的 `ch341` 不认 CH343，也没装 WCH 的 out-of-tree 驱动。
现在把 CH343 插上去，根本不会出现 tty 设备 —— 底盘直接连不上。**
厂商那两条 `ttyCH343USB*` / `ttyACM*` 规则在这台板子上本来也永远不会命中。

**所以：**

| 你的情况 | 结论 |
|---|---|
| 每台 RK3588 同时只接**一个**底盘适配器 | **不用换。** 现在的 CH340 规则够用 —— 没有"两个分不清"的问题要解决 |
| 想要"插到哪个口都能认出来" | 先用 `/dev/serial/by-path/`（已经自动生成，不用写规则）。按物理口的失败模式是**没有软链接=响声很大的失败**，比"认到错的车"安全 |
| 会有**两个** USB 串口适配器插在同一台 RK3588 上（两辆车共用一个上位机、台架同时接两套） | **这时才值得换** —— 而且**先花 1 分钟验证**：插一个 CH343 上去看 `dmesg` 有没有出 tty。没有就先装 WCH 驱动，然后你就得跟着内核升级维护它 |

**换 CH343 唯一无法替代的好处**：身份不依赖物理口。按物理口钉死在"重新布线"时会
失效 —— 本车就出现过这种情况（之前 `dmesg` 里底盘 CH340 在 **`3-1.2`**，现在在
**`1-1`**）。不过我们平时用 **ST-Link(SWD) 烧录**，串口线不动，所以这个风险在
正常工作下很小。

**建议顺序**：① 先把抢软链接的多余规则禁掉（跟芯片无关，现在是真隐患）；
② 需要的话给 CH340 规则加 `KERNELS=="1-1"`；③ **只有在真的要多个适配器共存时**
才换 CH343，并且换之前先验驱动。

---

## 安全机制

| 机制 | 行为 |
|---|---|
| STM32 看门狗 | 上位机 800ms 不发命令 → 刹车 + 断开滚刷/水泵继电器 |
| 上电 | 先发刹车帧、继电器断开 |
| 上电自检点动 | ★ **上电 3 秒后车会自己往前动一下**（约 7~16 cm，见下节）—— 这是全固件**唯一**一处不靠上位机命令就会动的行为，边界写在 `SELFTEST_*` |
| 命令限幅 | `MAX_LIN_SPEED` / `MAX_YAW_RATE` 夹住，上位机发疯也冲不出去 |
| 待机 | 每个控制周期重发同一帧刹车，**无状态**（见下） |
| 轮速外环修正 | 目标为 0 时恒定输出 0 —— 外环**无法**在停车指令下把车带着走；且总输出限在 ±`MAX_RPM` |
| 驱动器就绪联锁 | 两个驱动器没都回码时**只发刹车**，不发速度（差速车单轮出力 = 原地打转） |

### ★ 上电自检点动：上电 3 秒后会自己往前动一下

**这是全固件唯一一处"不等上位机命令就自己动"**，用途是**自检**：证明
**驱动器 / CAN / 电机 / 接线方向**这整条链是好的 —— 动一下就说明都通；
不动就说明有问题（配合诊断帧的 `flags` bit5 和驱动器故障码能定位到哪一环）。

```c
#define SELFTEST_ENABLE     1
#define SELFTEST_DELAY_MS   3000    /* ★ 上电先等 3 秒再动 */
#define SELFTEST_VX         0.25f   /* 点动速度 m/s(必须高于起步门槛) */
#define SELFTEST_MS         300     /* 点动时长 */
#define SELFTEST_READY_MS   2000    /* 等驱动器回码的上限 */
#define SELFTEST_ABORT_MS   3000    /* 开动后的硬上限, 到点必停 */
```

**★ 上电时人不要站在车前面。** 板子一上电 PB9 就开始闪，所以这 3 秒不是静默的 ——
看到灯在闪就知道板子活了、接下来会动一下。

**边界（五条，写在 `main.c` 的 `SELFTEST_*` 注释里）：**

| 条件 | 行为 |
|---|---|
| 上电后 3 秒内 | **什么都不做**，一直发刹车帧 |
| 3 秒到，两个驱动器都回过码 | 往前点动 `SELFTEST_MS`，然后归零刹车 |
| 3 秒到，驱动器还没就绪 | 再等 `SELFTEST_READY_MS`，还没有就**放弃自检**（不动） |
| 上位机开始发指令（`ever_linked`） | **立刻让位**，自检作废 —— 绝不和主人抢车 |
| 上次复位是**看门狗**（IWDG） | **跳过自检** —— 说明刚才是跑着跑着卡死的，车可能贴着墙/在人旁边，不能再窜一下 |

**"10cm"只是名义值，不是承诺：** 命令 `0.25 × 0.30 = 7.5 cm`，但停车后还会滑
（本车没有保持力，见 §5.1.1），实际约 **洗地机 12 cm / 扫地机 16 cm**。
要更接近 10 cm 就把 `SELFTEST_MS` 调小（每减 100 ms 少走约 2.5 cm）。
**真要精确 10 cm 得在上位机用 EKF 里程计闭环**，这条开环点动做不到。

**自检结果怎么看：**

- 肉眼：**有没有往前动一下**（最直接）
- 诊断帧 `f[30]` bit7 = 1 → **点动期间两个轮子实际转速一直是 0**，自检没过；
  `decode_diag.py` 会印成 `★上电自检:两轮都没转!`
- ⚠ bit7 = 0 有歧义：可能是"通过了"，也可能是"压根没跑"（驱动器没就绪放弃 /
  上位机先接管 / 看门狗复位跳过）。只有一个空位，分不出这三种。

> **给做导航的同事**：自检会在**上位机起来之前**把车往前挪 ~12 cm。所以正确的
> 顺序是"**先上电（含自检）→ 再摆位/设初始位姿**"。如果先设了初始位姿再重启底盘，
> 那个位姿会偏 ~12 cm。另外 STM32 若因看门狗复位，是**不会**自检的。

### 状态灯（PB9）：上电后一直闪

PB9 接一个灯，上电后 **2 Hz** 闪（亮 250 ms / 灭 250 ms）。

```c
#define LED_ENABLE          1
#define LED_PIN             GPIO_Pin_9
#define LED_ON_LEVEL        1       /* ★ 亮灭反了就改成 0 */
#define LED_BLINK_MS        250     /* 半周期, 2Hz */
```

**为什么放在 PB9**：查过全片没有冲突 —— CAN1 走 PA11/PA12（**没有**重映射，所以
PB8/PB9 本来就不是 CAN 脚），USART1 走 PA9/PA10，IMU 走 PB10/PB11，继电器是
PB0/PB1；PB9 也不在 JTAG 那五个脚里（PA13/14/15 + PB3/PB4），不需要任何重映射。

**它是翻转式的，不是延时式的**：在 `main()` 循环里按 `g_tick_ms` 到点翻转，不阻塞。
所以顺带就是"主循环还活着"的指示 —— **主循环卡住灯就定住**（1 秒后 IWDG 复位，
复位后重新闪）。现场排查"车不动"时这是最快的分叉：

| 现象 | 结论 |
|---|---|
| 灯不闪（常量亮或常量灭） | **MCU 没在跑** —— 查供电、BOOT0 有没有拨回来、有没有一直在复位 |
| 灯正常闪但车不动 | MCU 是好的 → 问题在驱动器/CAN/命令链，用 `tools/field_diag.sh` 往下查 |

`LED_ON_LEVEL` 是点亮电平，**取决于你接的是哪种灯**：自己拿 LED + 1kΩ 串到 GND 就是
`1`；"低电平触发"的现成模块（标 L）就改成 `0`。接反了不烧，只是亮灭颠倒。

### 继电器（PB0 滚刷 / PB1 水泵）—— 和轮毂电机无关

| | 上电 | 什么时候合闸 | 控制什么 |
|---|---|---|---|
| **滚刷继电器** PB0 | 断开 | **只能由上位机显式发 `f[1]=0x05` 帧** | 扫地滚刷电机 |
| **水泵继电器** PB1 | 断开 | **只能由上位机显式发 `f[1]=0x05` 帧** | 水泵 |

`f[2]` 是掩码：`bit0` 滚刷、`bit1` 水泵。

> ★ **这两个继电器是"外设开关"，和轮毂电机没有任何关系。**
> 轮毂电机的 FOC 驱动器是**独立供电、常电**的 —— 继电器断开不给它们断电，
> 它们的 CAN 通信和使能状态都不受影响。
>
> 这条以前写错了（PB0 叫 `RELAY_MOTOR` / "电机继电器"，还写成"继电器给驱动器
> 供电"），结果所有基于"继电器合闸 = 驱动器上电初始化"的推理全是错的，白追了
> 一轮"为什么第一条命令没反应"。**名字已经全改成滚刷**，别再叫电机。

**滚刷曾经是"收到运动命令就自动合闸"**，但那个行为的理由（"不合闸电机就没电"）
本身就是错的 —— 那个"电机"指的是轮毂驱动电机，继电器根本不管它。于是它成了一个
**没人明确决定过的副作用**：一给运动命令扫地滚刷就转。**已按需求改成显式控制。**

**★ 两条看门狗必须分清**（以前混成一条，导致显式控制根本没法用）：

| | 判据 | 动作 |
|---|---|---|
| **运动看门狗** | 800ms 没收到**速度帧** | `target` 归零 + 刹车 |
| **链路看门狗** | 800ms 没收到**任何合法帧** | 断开两个继电器 |

分开的理由：只发继电器帧时，车必须停住（没有速度命令），但滚刷要保持转 ——
混成一条的话，继电器帧不算喂狗，"开滚刷"会在 800ms 后自己被断链保护关掉。

**怎么控制它们**（两条通路都对）：

```bash
# A) 台架: 直接开关 (需要先停掉 ROS 底盘节点, 串口独占)
python3 tools/decode_diag.py -p /dev/wheeltec_controller --relay 1   # 滚刷开
# 1=滚刷 2=水泵 3=都开 0=都关; Ctrl-C 退出时会自动发 0

# B) ROS 跑着的时候: 走厂商节点的转发通路 (见下)
ros2 topic pub --once /chassis_relay std_msgs/msg/UInt8 "{data: 1}"
```

**ROS 侧为什么必须靠厂商节点转发**：这条 `f[1]=0x05` 是本工程自定义的扩展，
厂商 `wheeltec_robot_node` 不认识它，而且它**独占串口** —— 别的进程根本写不进去。
所以在厂商节点里加了一个订阅者（`/chassis_relay`，`std_msgs/UInt8`）代为转发。

改动以补丁形式存在本仓库：**`vendor-patches/chassis_relay_vendor.patch`**
（纯新增 0 删除，可用 `git checkout` 撤销）。

> ⚠ 补丁里有一个 **200ms 的定时器** `Relay_Hold_Timer`，它才是关键：本节点只在
> `/cmd_vel` 到来时才发帧，而 STM32 的**链路看门狗** 800ms 收不到任何合法帧就把
> 两个继电器都断开 —— 不加定时器的话，"停着不动时开着滚刷"会被看门狗自己关掉。

---

## 已知的坑（都踩过）

- **继电器模块必须和 STM32 共电源共地**，否则光耦半开、线圈半通电、持续嗡嗡响
- **STM32F1 的 USART 没有 RX FIFO**，收包必须用中断 + 环形缓冲，轮询一定会丢字节
- **CAN 收发器和 STM32 之间选对电平**，PA11/PA12 不是 5V 容忍
- **Blue Pill 的 PA11/PA12 同时连着 USB 座**，用 CAN 时别插那种会短接 D+/D- 的充电器
- **不要用「位置模式锁位」实现待机时锁死轮子**（重要，已踩）。做法是先刹停、
  再切 `MODE_POSITION`、然后每个周期死守驱动器回码里的位置。它在台架上表现很好
  （推一下会弹回原位），但**实车上直接失控**：驱动器被切出速度模式后，靠一路
  陈旧的绝对位置目标维持，多出「模式切换」和「位置目标」两个变量。
  现已删除，停车路径是**无状态**的——每个控制周期重发同一条帧，不记忆、不切换。
  想调待机手感只改 `main.c` 里的 `STOP_CTRL` 一个宏（`CTRL_BRAKE` 动态制动 /
  `CTRL_DISABLE` 自由滑行 / `CTRL_ENABLE`+0）。实测 `CTRL_BRAKE` 在低速时制动力
  很弱，慢慢推仍能推动——这是这台驱动器的固有特性，用锁位去换它的代价不值得。
- **原地转向时两个轮子反向转是正常的**，不是故障。左轮 `vx - wz·b/2`、右轮
  `vx + wz·b/2`，原地转（`vx=0`）时两轮等速反向。看到「内轮倒转」别急着断电。
- **串口是独占的**：厂商 ROS 节点开着的时候，`decode_diag.py` 打不开同一个口。
  看诊断数据必须先停节点。
- **改诊断帧长度时三处要同步**：`main.c` 的 `DIAG_FRAME_SIZE`、
  文件头的布局注释、`tools/decode_diag.py` 里的 `DIAG_SIZE`。对不上会静默丢帧。
- **给 YbImu 读长块会把模块卡死**（重要，已踩）。为了查"陀螺仪为什么恒 0"，
  加了一个寄存器体检去读 `0x16`（四元数，**16 字节**）和 `0x26`（欧拉角，12 字节）。
  结果 IMU 诊断码从 `陀螺仪恒 0` 直接变成 `总线死`（起始条件拉不起来），
  **连本来正常的加速度都读不到了，而且一直不恢复** —— 为了诊断把器件搞死，
  比不做体检还糟。现在体检只读 3/6/6 字节这些短块
  （`0x01` 版本 / `0x0A` 陀螺 / `0x10` 磁力）。
 真要再试长块，得先确认那颗模块上确实存在这些寄存器 —— 头文件那份表可能
  抄自另一个批次的变种（本车读到 `ver=1`）。
- **I2C 驱动的错误路径必须发 STOP**。同一个坑暴露出的底层缺陷：`YbImu_ReadRegs()`
  有几条错误分支 `return` 前没发 STOP，从机会一直拉着 SDA 不放，**整条总线
  卡死到断电为止**。已全部补上，并加了标准总线恢复（空闲时发现 SDA 被拉住就
  补 9 个 SCL 脉冲让从机松手）。任何 I2C 驱动都该有这个。
- **不要用"读一遍所有寄存器"来判断模块死活之后就把结论写死**。体检标志位里
  "没读到"和"读到了但是 0"是两回事，显示时不能混为一谈，否则会把人带偏。
- **"监控工具本身也会成为故障源"**（重要，已踩）。第一版底盘看门狗每 10 秒新建一个
  ROS 节点、只转 4 秒就判 `/odom` 死活，而**新建节点的 DDS 发现本身可能就要好几秒**
  —— 于是它在**完全健康的栈上反复误判重启**，日志里实打实重启了 3 次。每次重启
  `/odom` 位姿归零，正在进行的测量被截断，现象是"车明明动了、里程计只涨一点点"，
  而且**完全不可复现**，为此白追了好几轮。现在改成：进程没了才立即重启（不依赖
  DDS）；数据探测要**连续失败 3 次（30 秒）**才动手。另外 `pgrep -f` 的模式要带前导
  斜杠（`/wheeltec_robot_node`），否则它会匹配到任何命令行里含这串字的进程 —— 实测
  匹配到了自己那条 `pgrep` 命令，于是节点真死了也可能被判成"还活着"。
- **"诊断脚本僵住不退"会悄悄毁掉后面所有测量**（重要，已踩）。`decode_diag.py`
  在读线程报 `SerialException` 之后，卡在 `halt()` 里那个**没有超时的 `write()`**
  上（CH340 在 USB 层掉线后 write 会阻塞）—— 进程**僵了 19 分钟不退出、还一直
  开着串口**；同一时期的 `turn_sweep.sh` 也没退。之后所有测量都是在"两个进程读
  同一个 tty"的状态下做的：字节被随机分走、丢帧，数据全废，而且**极难察觉**
  （现象只是"数字有点怪"）。已修三处：
  1. `serial.Serial(..., write_timeout=0.3)`，`write` 不再可能无限阻塞；
  2. 三个工具结尾都加 `os._exit(0)`，不给"优雅关闭卡住"留任何机会；
  3. `turn_truth.py` / `chassis_check.py` 启动后**自检 `/cmd_vel` 的发布者数**，
     发现除自己以外还有人在发速度就拒绝测量，并打印怎么查。
  **诊断工具的底线：宁可难看地强退，也绝不能僵在那里占着串口。**
- **`pgrep -f` / `pkill -f` 会匹配到"任何"命令行里含这串字的进程 —— 包括你自己。**
  这个陷阱栽过三次：看门狗的 `wheeltec_robot_node` 匹配到自己；我在 ssh 里敲
  `pgrep -c -f '/wheeltec_robot_node'` 把自己数了进去，误判"有两份栈"；
  `pkill -9 -f 'turn_sweep.sh'` 更是直接把自己那条 ssh 命令行杀了、命令当场中断。
  写这类判据时：模式里带路径前缀，**或者干脆用 `ps -eo pid,cmd | grep xxx |
  grep -v grep`** 再数。
- **看门狗会和台架调试抢串口，必须先暂停它。** `decode_diag.py --drive` 要求先
  停掉 ROS 节点（串口独占），而看门狗把"节点进程没了"当成故障、每 10 秒把栈拉
  回来抢串口 —— 实测连着重启了 4 次，`decode_diag` 最后报
  `multiple access on port?`，数据是废的。现在支持手动暂停：
  ```bash
  touch /tmp/chassis_watchdog.pause    # 调试前
  rm    /tmp/chassis_watchdog.pause    # 调完一定要删!
  ```
- **栈的完整性要查两个进程，不能只看 node。** 实测 `pkill` 掉 `ros2 launch` 之后
  `wheeltec_robot_node` 还活着，只查 node 就会认为"一切正常"—— 但这时 respawn
  已经不工作了。看门狗现在两个都查。
- **"同一条直行命令连发三次，结果分别是没反应 / 向左转 / 正常前进"**（重要，已踩，**根因未定**）。
  直行变左转只有一个解释：**那一次只有一个轮子出力** —— 差速车单轮出力就是原地打转。
  现在的对策是**驱动器就绪联锁** `Drive_Ready()`：两个驱动器没**各自回过码**、
  或者有一路**现在不回码**（超过 `RPM_STALE_MS`），就**只发刹车、不发速度**。
  这样单轮驱动的情况会被直接刹住，而不是变成一次歪着走。
  诊断帧 flags 新增 **bit5**，`decode_diag` 会打印 `驱动器未就绪(等回码, 车被刹住)`。
  > ⚠ 我一度把根因归到"继电器断了给驱动器断电、驱动器在重新上电初始化"——
  > **那是错的**，继电器管的是滚刷和水泵，和轮毂驱动器无关（驱动器常电）。
  > 等待条件本身仍然是对的，错的只是理由，所以联锁保留、理由重写。
  > **真正的根因还没查明**：需要抓到一次"失败那趟"的逐帧数据才能定性 ——
  > 看两个轮的 `目标` 是不是就已经不一样（STM32/上位机侧），
  > 还是 `目标` 一样而 `实际` 只有一个在动（驱动器/静摩擦侧）。
- **不能用"指令 vs 里程计"来验证里程计是否说真话**（重要，已踩）。`/odom` 的角速度
  就是 STM32 按轮速算出来的值、厂商节点直接取用，**它和指令同源，比值恒等于 1**，
  什么都验证不了。要验证只能找**独立的物理量**：IMU 陀螺仪、激光雷达，或者卷尺。
- **`systemctl restart` 会杀掉服务 cgroup 里的所有进程**。看门狗用 `nohup` 拉起的
  底盘栈属于它那个 service 的 cgroup，默认 `KillMode=control-group` 下
  `systemctl restart chassis-watchdog` 会把**正在正常工作的底盘连坐干掉**（实测
  踩到：停掉看门狗之后 `/odom` 立刻没了，一开始还以为是别的原因）。service 里已加
  `KillMode=process`。底盘该由 `chassis_bringup.sh` 管，不该被看门狗的启停连坐。

### IMU 陀螺仪"恒零"？—— 假故障，已撤销

**曾经的结论**：加速度正常、磁力计正常，只有陀螺仪三个轴全是字面 0，于是判定
陀螺仪坏了。

**实际是错的。** 当时的判据来自一个**没有依据的假设**——"真实陀螺仪静止也有
噪声"。实测结论正相反：**这颗模块在检测到静止时会把角速度输出直接置零**。
静止时 478/799 帧为 0，一旦转动就有 321 帧非零。所以"静止时读到 0"是它的
正常行为，不是故障。

**怎么判断陀螺仪死活**：只能靠"转一下看数值变不变"，**不能靠静止读数**。
固件里 `imu_gyro_ok` 现在的含义是"曾经读到过非零角速度"。

顺带把**符号**也验证了：原地左转（俯视逆时针）时 `/imu/data_raw` 的
`angular_velocity.z` 为**正**、右转为负，所以 `IMU_GYRO_Z_SIGN 1` 是对的。

**对 ROS 的影响**：厂商 EKF 确实在用它 —— `/imu/data_raw` 的
`angular_velocity_covariance[8] = 2.5e-3`（标准差 0.05 rad/s），是转动的主要
信息源；实测 `/odom_combined` 的偏航角和 IMU 几乎重合（73% vs 74%）。
（曾经以为"EKF 把它协方差设成 1e6 所以根本没在用"，那是把 **orientation** 的
1e6 当成了 angular_velocity。）

**遗留的真实缺口**：EKF 目前**没有任何绝对偏航参照**（没融合磁力计、也没雷达），
所以航向长期会漂。这个要等雷达装上、跑起 SLAM 才能治本。
