SkyHao723/sweeper_chassis/docs/nav2-reference.md

# 底盘接口与精度参考（给做 Nav2 定位/导航的同事）

> 对象：**在 RK3588 上开发 ROS 2 Humble + Nav2 的定位/导航**。
> 内容：这台清扫车底盘**能给你什么、不能给你什么、哪些数字可以直接引用**。
> 全部数字都是实车实测的，测量方法和条件写在旁边 —— **别脱离条件引用**。
>
> 底盘控制是自研 STM32 固件（`firmware/stm32-chassis/`），厂商只提供了
> `wheeltec_robot_node` 这个串口桥。凡是"厂商默认值没实测过"的地方，都标了 ⚠。

---

## 0. 一页速查

| 你想干的事 | 用什么 |
|---|---|
| 发速度 | `/cmd_vel`（`geometry_msgs/Twist`），**20 Hz 持续发** |
| 拿里程计（**Nav2 用这个**） | `/odom_combined`（EKF 输出），TF 父帧 `odom_combined` |
| 拿纯轮速里程计（对照/调试用） | `/odom`，**它没有 TF**，`odom` 是孤儿帧 |
| 拿 IMU | `/imu/data_raw`（20 Hz，含三轴角速度/加速度/解算姿态） |
| 电池电压 | `/PowerVoltage` |
| 开关扫地滚刷 / 水泵（本车扩展） | `/chassis_relay`（`std_msgs/UInt8`：bit0 滚刷 bit1 水泵） |
| **本次导航速度上限** | `vx ≤ 0.30~0.35 m/s`，`|wz| ≥ 0.35 rad/s`（理由见 §3） |
| **发布 `/cmd_vel` 的频率** | **必须 ≥ 2 Hz 持续发**（8 百毫秒不发，底盘自己刹车） |

**四条最容易踩的**：

1. **`odom` 帧没有 TF**，只有 `odom_combined` 有。Nav2 的 `odom_topic` 用
   `/odom_combined`，`odom_frame` 写 `odom_combined`。
2. **底盘不保持最后一条命令。** 800 ms 没收到速度帧 → 目标归零 + 刹车 + 锁存
   （诊断帧 `flags` bit1）。所以**你的控制器必须按固定频率持续发 `/cmd_vel`**；
   发一条就退出，车只走 0.8 秒。Nav2 默认 20 Hz，没问题；自己写的发布节点要注意。
3. **阶跃起步会过冲**：你发 0.30，车会先冲一下再落回（历史实测峰值约 138%）。
   固件在 2026-09 改过起步助推，过冲已经压下去，但**还没重测**（见 §2.4）。
   Nav2 的限速、以及任何"按时间估算应走多远"的检查都要容忍这个。
4. **停车后会滑约 12 cm**（低速时刹车力弱）。`goal` 的容差要留够。

---

## 1. 话题与坐标系

### 1.1 话题

| 话题 | 类型 | frame_id → child | 频率（实测） | 谁发 |
|---|---|---|---|---|
| `/odom` | `nav_msgs/Odometry` | `odom` → `base_footprint` | **20.0~20.2 Hz** | `wheeltec_robot_node`（纯轮速积分） |
| `/odom_combined` | `nav_msgs/Odometry` | `odom_combined` → `base_footprint` | ~20 Hz | `ekf_filter_node` |
| `/imu/data_raw` | `sensor_msgs/Imu` | `gyro_link` | 20 Hz | `wheeltec_robot_node` |
| `/PowerVoltage` | `std_msgs/Float32` | — | 低 | 同上 |
| `/cmd_vel` | `geometry_msgs/Twist` | — | **订阅，≥20 Hz** | 你发 |
| `/odometry/filtered` | 同 `/odom_combined` | — | — | EKF（remap 别名） |
| `/chassis_relay` | `std_msgs/UInt8` | — | 事件 | 你发（本车扩展，需厂商节点转发） |

### 1.2 TF 树（★ 先看这张图再看代码）

```
map ──(SLAM/AMCL 发布, 目前没有)──► odom_combined ──(EKF 发布)──► base_footprint
                                                                    │
                                          (robot_state_publisher, URDF) │
                                                                       ▼
                                        base_link / laser / gyro_link / radar …
```

- **只有 EKF 发 `odom_combined → base_footprint` 这一条动态 TF**（`ekf.yaml`
  里 `publish_tf: true`）。厂商节点**不发 TF** —— 它只在 `/odom` 消息里填了
  `frame_id`/`child_frame_id`，**没有 `sendTransform`**。所以 `odom` 这个帧
  **没有任何 TF 连到树上**，是个孤儿帧。
- `base_footprint → 各传感器`由 `robot_state_publisher`（URDF）和四个
  `static_transform_publisher`（`base_to_link` / `base_to_laser` /
  `base_to_gyro` / `base_to_radar`）发布。
- **`base_footprint` 的定义是"两个驱动轮触地点的中点在地面的投影"** ——
  所有传感器外参都要从这一点量（见 §6.3）。

### 1.3 `/cmd_vel` 的语义

| 字段 | 单位 | 正方向 |
|---|---|---|
| `linear.x` | m/s | **前进** |
| `angular.z` | rad/s | **左转**（从上往下看逆时针）—— 用 IMU 验过 ✓ |

`linear.y` 忽略（差速车）。固件内的限幅是 `|vx| ≤ 2.15 m/s`、`|wz| ≤ 3.0 rad/s`
—— **很高，不能当安全网**，请自己在 Nav2 侧限。

**为什么必须持续发**：STM32 有 **800 ms 运动看门狗** —— 收不到速度帧就自动把
目标冻结。停止发布 = 停车，这是设计的安全网之一。`ros2 topic pub --once` 只会让
车动不到 0.8 秒。

---

## 2. 实测精度（可以直接引用）

> 除非另外注明，都是**最近一次固件**（外环带"线性带"那版）在**轮子着地**下测的。
> 工具：`tools/straight_quality.py`、`tools/turn_truth.py`、`tools/chassis_check.py`。

### 2.1 直线（命令 0.30 m/s，持续 10 秒，实测 3.0 m）

| 指标 | 实测 | 说明 |
|---|---|---|
| **平均速度** | **92%**（另一趟 **99%**） | 用 `/odom` twist 平均 |
| 路径长度 | 92%（另一趟 99%） | 用 `/odom` 位姿积分 |
| **真实偏航**（IMU 积分） | **−0.36° / 3 m = 0.12°/m** | 命令 `wz=0`，所以这就是"车实际歪了多少" |
| **里程计偏航 vs IMU 真值** | **−0.08°**（0.03°/m） | 轮速里程计的诚实度 |
| **一次过冲** | 峰值到 **138%**，约 **3 秒**落回 | 驱动器速度环的阶跃响应 |
| IMU 陀螺零偏 | **−0.0007 rad/s**（0.04°/s） | 直行时 `wz` 均值 |
| IMU 陀螺噪声 | **σ = 0.069 rad/s**（行驶中） | 见 §5.2 |

**结论：直线精度够用。** 主要误差是那一次过冲（一次性瞬态，不影响平均）。

### 2.2 原地转（`wz = 0.5 / 0.7 / 1.0`，持续 4 秒）

| 命令 wz | 单轮目标 | 4 秒转过总角度（对 IMU 真值） |
|---|---|---|
| 0.50 | 21.6 RPM | **101%** |
| 0.70 | 30.3 RPM | **100%** |
| 1.00 | 43.3 RPM | **102%** |
| 0.30 | 13.0 RPM | **49%** ⚠ 别用这个档 |

- 稳态转速 95~99%。**末段不再塌陷**（早期版本会退到 14~54%）。
- ⚠ 以上是**外环 v2** 测的；之后给外环加了"线性带"（只影响积分、不动起步助推），
  **原地转没有重测**，但预期相近。`0.30` 这一档从 v1 就一直很差，属于低速死区。
- ⚠⚠ 更要紧的：这几档的**起步助推**在 2026-09 换掉了（见 §2.4）。旧助推是
  固定 +12 RPM 加性量，等效于每次原地转起步都**额外加 0.28 rad/s**，
  也就是说上表 0.50 档起步那 400 ms 真实 wz 约 0.78（155%）。新固件按缺口给量，
  `|wz| ≥ 0.35` **完全不加助推**。所以**上表需要重测**；预计稳态不变、起步段变平。

### 2.4 起步助推（2026-09 改动，★ 未上车验证）

实车报过两个症状，**是同一个根因的两端**：

| 症状 | 根因 |
|---|---|
| 发小一点的转向命令，车愣在原地 | 旧助推是 **400 ms 一次性定时**，超时就撤，且目标没回零就**不会重新武装** |
| 转向太敏感 | 旧助推是**固定 +12 RPM 加性**，原地转时等效 **+0.28 rad/s**；每次起步都给满 400 ms |

新逻辑（`KICK_*` 宏，都在 `user/main.c`）：

```
助推 = clamp(15 - 较小的那个|名义轮速|, 0, 20)   RPM
只在 |实际轮速| < 2 RPM 时给;  |实际| > 6 RPM 立刻撤
补到 15 还不动 -> 每 200ms 再加 4 RPM, 到 20 封顶
加到 20 还不动满 3 秒 -> 歇 2 秒再试(不是永久放弃), 诊断帧 flags bit7 锁存置位
```

对导航的直接含义：

- **`|wz| ≥ 0.35 rad/s`（单轮名义 ≥15 RPM）：完全不加助推，干净。**
- `|wz| < 0.35`：从静止起步时助推会把 wz **临时**抬高（0.25 档约 +0.10 rad/s）。
  这不是 bug，是**破静摩擦的物理代价** —— 这个驱动器从静止起步就是要约
  15 RPM 才动得起来。
- 因此 **Nav2 的 `min_speed_theta` 建议 0.35**，并且尽量避免让 Nav2 规划出
  "原地几乎不转"的微调动作。
- **边走边转（两轮名义值同号）不受偏航影响**：助推给两轮加的是同一个方向，
  差分不变 → `wz` 诚实，只是 `vx` 会短暂冲高一点。所以"转向变敏感"只可能来自
  **原地转**，直行/弧线里不用担心。
- 调试时看诊断帧 `flags`：**bit6 = 此刻正在给助推**，bit7 = 加到上限还不转。
  两者都能用 `tools/decode_diag.py` 直接读出来。

### 2.3 距离刻度

- 用 `chassis_check.py --drive-to 1.0`（把里程计钉在 1.0 m 就停）测到车实际停在
  **约 1.12 m**。**但其中约 12 cm 是停车后的滑行**，所以**不能用它当刻度结论**。
- 交叉验证：原地转时 `/odom` 的偏航相对 IMU 只低 **2.6~3.8%**，而轮速里程计的
  偏航 = `轮速 × 周长 / 轮距`，**对周长的灵敏度和直行一样** —— 若周长真差 11%，
  偏航也该差 11%。所以**刻度误差远小于 11%，大概率在 3% 上下**。
- ⚠ **权威做法**：沿地面参照线跑 4 m 以上，量真实距离，再用
  `base_serial.launch.py` 里的 `odom_x_scale` 修（**只影响里程计积分，不影响
  下发指令**，所以随便调，不用重烧固件）。

---

## 3. ★ 速度包线（配 Nav2 参数看这一节）

> ★★ **本节所有实测数字都是"扫地机"（轮径 205mm / 轮距 930mm）的。**
> 现在还有一辆**洗地机（150mm / 425mm）**，几何不同 → 换算系数完全不同。
> **洗地机必须重新测**，不能照抄下面的数。两车对照见 §3.1。

**扫地机（实测值）**：

| 区间 | 表现 | 建议 |
|---|---|---|
| `vx < 0.22 m/s` | **驱动器速度环不稳**（单轮 <20 RPM 进入死区/极限环） | **不要在 Nav2 里用** |
| **`vx = 0.25~0.35 m/s`** | 均值 92~103%，最稳 | **推荐工作区** |
| `vx > 0.5 m/s` | 超速（早期实测 134%） | 别用 |
| **`\|wz\| < 0.35 rad/s`** | 单轮名义 <15 RPM，**从静止起步要靠助推才动**（见 §2.4） | 设成 Nav2 的最小角速度 |

### 3.1 两车几何对照（★ 换算系数完全不同，别混用）

固件是**一份源码、编译期选车型**（`main.c` 的 `VEHICLE_SEL`）：

| | 扫地机 sweeper | 洗地机 scrubber |
|---|---|---|
| 轮径 / 轮距 | 205 mm / 930 mm | **150 mm / 425 mm** |
| 轮周长 | 0.64403 m | **0.47124 m** |
| `vx` → 单轮 RPM | `rpm = vx × 93.03` | **`rpm = vx × 127.32`** |
| `wz` → 单轮 RPM | `rpm = wz × 43.26` | **`rpm = wz × 27.06`** |
| 单轮 RPM → 线速 | `v = rpm × 0.010734` | **`v = rpm × 0.0078540`** |
| 最大线速（200 RPM） | 2.147 m/s | **1.571 m/s** |
| **起步门槛 15 RPM 对应的** | | |
| · 最低直线速度 | 0.22 m/s | **0.12 m/s** |
| · 最低原地转角 | 0.35 rad/s | **0.55 rad/s** |

两条要点：

1. **洗地机的"最低原地转角"反而更高（0.55 rad/s）** —— 轮距窄了，同样的轮速
   只能换来更小的角速度。所以 Nav2 的 `min_speed_theta` 在洗地机上**要更大**。
2. **起步门槛 15 RPM 是在扫地机上实测的**，它本质是**驱动器/电机**属性，
   洗地机换了电机/轮子就必须重测（用 §2.4 那套 `decode_diag` 观察
   `flags bit6 起步助推中` 什么时候消失）。

> ⚠ **选错车型的固件是安全级错误**：把扫地机的固件烧到洗地机上，转向增益会变成
> `930/425 = 2.19 倍`（转得过头一倍多），同时上报的 `body_wz` 只有真值的
> `425/930 = 0.457 倍` —— **EKF 会严重低估转角，导航会跑飞**。
> 固件已做三道防线：① `VEHICLE_SEL` 没选就 `#error` 编译失败；
> ② PB9 心跳灯的频率就是车型（**2Hz = 扫地机，5Hz = 洗地机**）；
> ③ 诊断帧 `f[30]` bit5-6 = 车型号，`tools/decode_diag.py` 会印出
> `车型=扫地机205/930` 或 `车型=洗地机150/425`。**上车前对一眼。**

**不要用单一系数去补速度误差。** 早期实测（外环之前，扫地机）：

```
0.15 m/s → 64%      0.30 m/s → 103%      0.50 m/s → 134%
```

**低速偏低、高速偏高**，是明显的非线性（≈`0.28 × 命令^1.51`）。用一个
全局 scale 会让某些档更糟（0.15 档要 ×1.56，0.50 档要 ×0.75）。

**原地转的起步要 1.5~2 秒**（`wz=1.0` 时第 0 秒也只有 36%）。所以
`RotationShim` / 原地转的超时、以及恢复行为的时间预算都要按这个留。

**停车滑行约 12 cm**（`CTRL_BRAKE` 低速制动力弱，是这台驱动器的固有特性）。
`xy_goal_tolerance` 要大于它。

---

## 4. EKF 现状

配置文件：`~/smart_ws/src/turn_on_wheeltec_robot/config/ekf.yaml`

| 项 | 值 |
|---|---|
| `frequency` | 20.0 |
| `two_d_mode` | true |
| `odom_frame` / `world_frame` | `odom_combined` |
| `base_link_frame` | `base_footprint` |
| `odom0` 融合 | 只融合 `x_vel` + `yaw_vel`（不融合位姿） |
| `imu0` 融合 | **只融合 `yaw_vel`** |
| `transform_time_offset` | **0.0**（刻意。非零会让 AMCL 拿扫描去配 150 ms 前的位姿，转弯时变成恒定的角度滞后，随转动累积） |
| `publish_tf` | true（**整个 TF 树的唯一动态边**） |

### 4.1 ★ 偏航几乎全靠 IMU，而 IMU 没有绝对参照

厂商给的协方差：`/odom` 的 yaw_vel 方差 **5e-2**（运动）/ **1e-2**（静止），
IMU 的 `angular_velocity_covariance[8]` = **2.5e-3** —— **IMU 权重是轮速的
4~20 倍**。所以 `/odom_combined` 的偏航 ≈ IMU 陀螺积分。

**这意味着**：

- 短期准（实测偏航 0.12°/m，比纯轮速还好）
- **但没有任何绝对参照 → 长期必然漂，且漂了回不来**
- 唯一的治本是**装上雷达跑 SLAM**（或者融合磁力计）

### 4.2 IMU 噪声比厂商假设的略大

实测行驶中陀螺 `wz` 标准差 **0.069 rad/s**，厂商假设 **0.05**（1.4 倍）。
而且噪声是**重尾**的（偶发 ±0.5 rad/s 尖峰，来自真实振动 —— 加速度计峰峰值
也有 2.5 m/s²）。IMU 的拒绝阈值是 100σ = 328°/s，**拦不住这些尖峰**。

**影响**：偏航的**均值**不受影响（尖峰正负对称，实测零偏只有 −0.0007 rad/s），
但**抖动**偏大。按实测把协方差改成 `0.069² ≈ 4.8e-3` 是个 1.9 倍的小修正，
收益有限，**不是当务之急**。

### 4.3 没做的（明确列出来，免得以为配好了）

- 没有融合磁力计、没有融合 `/odom` 的绝对位姿
- 没有 `use_control`（不用 `/cmd_vel` 预测）
- 没有融合 IMU 线加速度
- 传感器外参目前是厂商默认值，**不是实测值**（见 §6.3）

---

## 5. 已知故障模式与症状（省得重踩）

| 症状 | 真正原因 | 怎么办 |
|---|---|---|
| `/odom` **时有时无**、或突然消失 | CH340 在 USB 层掉线（内核日志有 `USB disconnect` + 重新枚举） | 软件侧有 `chassis-watchdog`（停发就重启栈）。**硬件侧要查 USB 线/接头** |
| `/odom` **一条都没有**，但话题存在 | ①STM32 没在发（供电/卡死）②**两个进程抢同一个串口** | `fuser -v /dev/wheeltec_controller`；用 `tools/decode_diag.py` 直接读原始串口 —— **它若也读不到，问题在 STM32 侧，不在 ROS** |
| 车**忽快忽慢**、完全不听 | `/cmd_vel` 上有**第二个发布者**在抢（`chassis-web.service` 开机自启；**只有网页里点了"使能"它才真发**） | `ros2 topic list` + `ros2 topic info /cmd_vel --verbose` 看发布者节点名 |
| **发 0 速车不停**（2026-10 踩过） | `/cmd_vel` 上有**多个发布者且没有仲裁**：`controller_server` 还在导航时以 ~20 Hz 发非零，把"停"覆盖掉了。只发一两帧 0 一定没用 | 见 §5.1 |
| 车**偶尔不动 / 偶尔歪一下** | 驱动器没都回码时单轮出力 = 原地打转 | 固件已有"就绪联锁"：两个驱动器没都回码就**只发刹车**。诊断帧 `flags` bit5 会显示 |
| 直行**跑偏** | 先排除假象：①IMU 死了（EKF 偏航会冻住，`flags` bit2/bit3）②`/odom` 不可信 | 用 `tools/straight_quality.py` —— **它拿 IMU 当真值**，并会自检 IMU 死活 |
| 低速**又慢又抖** | 驱动器速度环死区/极限环 | 别用 `<0.22 m/s`（§3）。这是驱动器的固有问题，**改 Nav2 参数救不了** |

**电磁/供电类的坑**（都会表现成"随机、不可复现"）：继电器模块必须和 STM32
**共电源共地**，否则光耦半开、线圈半通电、持续嗡嗡响；IMU 掉电时会表现为
`imu=无应答`，而它一死整个航向就没了。

### 5.1 ★ 为什么"发 0 速"停不下来：**先分清是哪一种**

"发 0 不停"有**两种完全不同的原因**，混在一起查会白绕很久（2026-10-10 就绕了）：

| | 现象 | 真正原因 | 去哪查 |
|---|---|---|---|
| **① 命令侧** | `/cmd_vel` 上**看不到**持续的 0（你的 0 被别人的非零盖掉） | 多发布者 + 无仲裁 | 本节下半 |
| **② 执行侧** | `/cmd_vel` **确实是持续的 0**，轮子也不转了，**但整车还在滚** | ★ **本车默认就是这个** —— 待机是"动态制动"，**没有保持力** | 本节 §5.1.1 |

**怎么分**：`bash tools/zero_stop_probe.sh`，同时看 `/cmd_vel` 和 `/odom`。
命令是 0 而 `/odom` 还在动 → ②；`/cmd_vel` 一直非零 → ①。

**★ 注意一个容易骗人的观察方式**：如果看的是**控制器自己的日志/话题**
（`sweeper_stanley_controller` 会打印 `"v_out":...,"w_out":...`），
那只能证明**这个控制器**输出 0，**不能证明 `/cmd_vel` 是 0** ——
`/cmd_vel` 上还有 4 个别的发布者，谁最后到谁算数。

#### 5.1.1 ★ 执行侧：本车停车后**没有保持力**（这就是"发 0 车不停"）

`main.c` 里 `#define STOP_CTRL CTRL_BRAKE`，而 `CTRL_BRAKE(0x03)` 是
**动态制动（相线短接）**：制动力**与转速成正比**，转速越低越小，
**静止时接近 0**。所以：

- 固件**确实**把两轮目标归零、每 20 ms 重发一条刹车帧 → **电机不再主动驱动**；
- 但它是**减速器，不是驻车制动**。一辆 200+ kg 的清扫车，靠惯性/地面摩擦对冲，
  会继续滚；**在坡道上会以一个终端速度一直爬**（重力矩恒定，而制动力 ∝ 速度，
  两者会在某个速度上平衡）。

三种待机方式的保持力**都≈0**（`main.c` 的注释实测过）：

| `STOP_CTRL` | 行为 | 静止时的保持力 |
|---|---|---|
| `CTRL_BRAKE (03)` | 动态制动，相线短接 | **≈0**（"慢慢推很轻"，实测） |
| `CTRL_DISABLE (02)` | 完全松开，自由滑行 | 0（更差） |
| `CTRL_ENABLE (01)+0` | 速度环，目标 0 | 注释说"速度环有静区 → 慢慢推也不出力"，⚠ **这条是假设，没实测过** |

**这是一次明确的取舍，不是 bug**：唯一能主动"顶住"的办法是**位置模式锁位**，
它在台架上表现很好（推一下会弹回原位），但**实车上直接失控**（驱动器被切出速度
模式后靠一路陈旧的绝对位置目标维持），已删除（见 `docs/ros-integration.md` 的
"位置锁位 / 已删除"）。删除之后停车路径是**无状态**的，代价就是没有保持力。

**验证（安全，不用发运动指令）**：让 STM32 持续发 0，人**慢慢推车**：

```bash
# 先停 ROS 底盘栈让出串口(见 README 的"已知的坑")
python3 tools/decode_diag.py -p /dev/wheeltec_controller --drive 0 0
# 另一个人慢慢推车 -> 看诊断帧里的"实际"轮速
#   一推就动、松手还滑  = 确认没有保持力(②)
```

**待办 / 可选方向**（按代价）：

1. **A/B `STOP_CTRL` 三种取值**（改一个宏重烧 + 上面那个手推测试）。
   尤其 **`CTRL_ENABLE+0` 值得实测**：如果这台驱动器的速度环有积分，它其实会
   **抵抗被推动**（速度环要把速度维持在 0），那就等于免费的"电子驻车"。
   注释里"有静区所以不出力"是**当时的假设**，我一直没验证过 ——
   这是一个便宜且可能直接解决问题的实验。
2. 真要"停住"，得恢复位置保持，但**必须先把上次失控的原因查清**，不能照原样加回来。
3. 机械驻车（抱闸）—— 超出本工程范围，但如果这是硬需求，正解是它。

#### 5.1.2 命令侧：`/cmd_vel` 没有仲裁（另一回事）

**底盘这一侧是对的**：收到 `vx=0,wz=0` 的速度帧，STM32 会立刻把目标归零并按
20 ms 周期发刹车帧（`main.c` 的 `Cmd_Apply` → `Drive_Apply`），而且会**解除**
看门狗停车锁存。也就是说底盘**认得** 0（能不能停住见 §5.1.1）。

问题在 `/cmd_vel` 是**一个订阅者 + N 个发布者、没有任何优先级仲裁**。
2026-10-10 实测到 **5 个发布者**：

| 发布者 | 数量 | 什么时候发 |
|---|---|---|
| `controller_server` | 1 | **跟着路径走的时候，按 `controller_frequency` 持续发**。本车加载的是自定义插件 **`sweeper_stanley_controller`**（`LY_sweep_ws/LY_sweeper/nav2_stanley_controller`，Stanley 路径跟踪 + costmap 避障），所以这条 `cmd_vel` 是**它**在往外推 |
| `behavior_server` | 3 | 恢复行为（spin/backup/drive_on_heading） |
| `stop_all_services` | 1 | 收到 `/ly_nav/stop_all` 时**只发 2 帧 0**（间隔 0.3 s）—— 源码里就这么写的 |

> ⚠ 两条**没有实测到**的：①"跟路径走时持续发"是 Nav2 的机制（当时没有 active goal，
> 20 秒里一条消息都没有），②发多快取决于 `controller_frequency`。
> 参数快照里写的是 **10.0**（注释：RK3588 满载时 20 Hz 会持续 miss，2026-09-22 降到 10），
> 但那是 `runtime_logs` 里的旧快照，**要以实际 launch 的值为准**：
> `ros2 param get /controller_server controller_frequency`。
>
> 这条**很关键**：如果它在 10 Hz，那么"自己发 0"至少要发得比它快才有机会，
> 而且即使 20 Hz 对 10 Hz，也只有 2/3 的帧是你的 0 —— 车会**一顿一顿地慢慢挪**，
> 不会干净地停住。**所以真正让车停下的是"取消目标"，不是"发 0"。**

ROS 2 里多条消息都送到同一个订阅者，**谁最后到谁算数**。所以：

```
你的 1~2 帧 0        ──┐
                       ├─► wheeltec_robot ─► STM32
controller_server     ──┘   10~20 Hz 非零, 50~100 ms 内就把 0 覆盖掉
```

**只发一两帧 0 在原理上就不可能停车**，只要还有别的节点在发。

**还有一个反推能帮你定位**：如果 0 真的生效了、而且之后**再没有任何速度帧**，
那么 STM32 自己的 **800 ms 运动看门狗**也会把车停住。所以"**完全不停**"只有
一种解释 —— **有别的节点在持续发非零**。（若车是"慢慢滑行/溜坡"才停不下来，
那是另一回事：驱动器低速制动力弱，参考 §3 的 12 cm 滑行。）

**修法**（按推荐顺序）：

**0. 立刻可用：`tools/cmd_vel_guard.py`（本仓库提供，不用改同事的 Nav2 配置）**

```bash
python3 tools/cmd_vel_guard.py &        # 起一个 /chassis_stop 服务
ros2 service call /chassis_stop std_srvs/srv/Trigger
```

它按**正确顺序**做三件事：

1. **先取消全部导航目标**（直接调 `/navigate_to_pose`、`/navigate_through_poses`、
   `/follow_path`、`/spin`、`/backup` 的 `_action/cancel_goal` 服务，`goal_info`
   全 0 = 取消所有目标）—— **这一步才是真正让车停下来的**，因为源头不闭嘴，
   发多少帧 0 都是白搭。
2. 再以 **20 Hz 持续发 0 共 1 秒**，让停车**立刻**生效，而不用等 STM32 那 800 ms。
3. **量给你看**：读 `/odom` 的车体速度，把"停没停"变成可验证的结论。还在动就
   **不再跟 Nav2 抢**（对着 20 Hz 发只会让车一抖一抖），直接返回失败 + 实测速度。

> **★ 为什么不用 `rclpy` 的 `ActionClient` 取消**：Humble 的 `ActionClient` **没有**
> 公开的 cancel-all 方法（实测 `dir(ActionClient)` 里只有私有的 `_cancel_goal` /
> `_cancel_goal_async`），而且它只能取消**自己发出的**目标。我们不是发目标的人，
> 所以走 action 底层的 `cancel_goal` 服务 —— 这是 ROS 2 给"非发起方要求取消"留的通道。
>
> **★ 一个 rclpy 的坑（这次踩了两个小时）**：不指定 `callback_group` 时，所有回调
> 都落在节点的**默认回调组，而默认是 `MutuallyExclusive`** —— 同一个组里的回调
> **永远不会并发**，哪怕你用的是 `MultiThreadedExecutor`。后果非常隐蔽：
> `/chassis_stop` 一阻塞（要发 1 秒的 0），`/odom` 回调就**一帧都收不到**，
> `cancel_goal` 的响应也永远处理不了（取消报 `none`）。**停车判定因此全是瞎的**，
> 而表面上看节点运行得好好的。必须把订阅/服务/客户端都放进
> `ReentrantCallbackGroup`。

**实测（2026-10-10，车静止，只发 0 不会让车动）**：

```
success = True
message = 已停车 (前 vx=0.000 wz=0.000 -> 后 vx=0.000 wz=0.000,
          取消目标=ok:/navigate_to_pose(rc=0),/navigate_through_poses(rc=0),
                    /spin(rc=0),/backup(rc=0),
          20 帧 0, 期间 /odom 30 帧)
```

⚠ **还没验证的是真正要紧的那一种**：车正在被 Nav2 驱动着的时候调用它。
那需要跑一次真导航（车会动、而且是 200+ kg），要有空旷场地和人在旁边。
复现顺序见 §5.2。

**1. 改 `stop_all_services.py` 的顺序。** 它现在是"发 2 帧 0 → 0.3 s 后再发 1 帧
→ 跑 `reset_ros.sh` 杀进程"。在 `controller_server` 被杀掉之前它一直在发非零，
那 2 帧等于没发。正确顺序：**先取消目标（或让 `controller_server` 失活）→ 再以
≥20 Hz 持续发 0 共 0.5~1 秒 → 最后才杀进程**。

**2. 加一个速度仲裁**（`twist_mux`，或自己写一个几十行的优先级 mux）：
急停/遥操走高优先级输入，Nav2 走低优先级；高优先级有 0.5 s 超时后自动让位。
Nav2 侧改成发 `/cmd_vel_nav`（改 `sweeper_stanley_controller` 的
`controller_server` 参数里的话题名），mux 输出 `/cmd_vel`。**这是架构上正确的
做法**，以后加遥控器、加急停都不会再打这个架。本机**没装** `twist_mux`
（`ros2 pkg prefix twist_mux` → not found）。

**3. 临时手动停车**：先取消目标/停 Nav2，再发 0；或者直接 `reset_ros.sh`。

> 顺带一个已知隐患：本仓库给 `wheeltec_robot` 打的滚刷/水泵补丁里，
> `Relay_Hold_Timer`（200 ms）会在 **`Relay_Mask != 0`** 时调用
> `Send_Relay_Frame()`，而它和 `Cmd_Vel_Callback` **共用同一个
> `Send_Data.tx[]` 缓冲且没有加锁**。滚刷/水泵关着时不会触发；一旦开着，
> 理论上存在"速度帧和继电器帧交错"的竞争。要开滚刷时留意这一条。

### 5.2 复现"发 0 停不下来"（车上，人在旁边）

```bash
# 0) 空旷场地, 人站在急停旁边。先确认底盘栈和 Nav2 都在跑
ros2 lifecycle get /controller_server          # active 才行
ros2 param get /controller_server controller_frequency   # 记下这个值

# 1) 先只读地看清楚 /cmd_vel 上有谁
bash tools/zero_stop_probe.sh

# 2) 起 guard, 让它把"取消目标 + 持续发 0 + 实测确认"一条龙做掉
python3 tools/cmd_vel_guard.py --hold 1.0 &    # 另开一个终端
# 3) 发一个导航目标让车跑起来, 然后在另一个终端:
ros2 service call /chassis_stop std_srvs/srv/Trigger
#    看返回: success=true 且 message 里"后 vx=..."接近 0 = 干净停住
#    若 success=false, message 会告诉你取消目标成没成、期间 /odom 收了多少帧

# 4) 对照实验(证明"只发一帧 0"没用):
ros2 topic pub --once /cmd_vel geometry_msgs/msg/Twist "{linear: {x: 0}}"
#    预期: 车几乎不停(1 帧在 50~100ms 内被覆盖)
```

---

## 6. 配置检查清单

### 6.1 ROS 环境

- **`ROS_DOMAIN_ID=5` 必须处处一致**。它写在 `.bashrc` 里，而 `.bashrc` 对
  **非交互 shell 会提前 return** —— 所以 `ssh host 'cmd'`、脚本、systemd 都会
  落到 domain 0，症状是"节点活着但收不到数据"，极难查。已经写进
  `/etc/environment` 兜住，但**你自己写的脚本里仍要显式 export**。
- 启动：`ros2 launch turn_on_wheeltec_robot turn_on_wheeltec_robot.launch.py`
  或 `bash ~/chassis_tools/chassis_bringup.sh start|stop|restart|status`

### 6.2 Nav2 侧要改的

```yaml
# 里程计
odom_topic: /odom_combined        # ★ 不是 /odom (那个没有 TF)
robot_base_frame: base_footprint
odom_frame: odom_combined

# 速度限幅（★ 见 §3）
max_vel_x: 0.30                   # 别超过 0.35
min_vel_x: 0.25                   # ★ 低于 0.22 驱动器会不稳
max_vel_theta: 1.0
min_speed_theta: 0.35             # ★ 单轮 15 RPM, 低于它从静止起步要靠助推(§2.4)
# 停车滑行约 12 cm
xy_goal_tolerance: 0.15
```

### 6.3 ⚠ 装雷达后**必须实测**的外参

`config/robot_model.yaml` 里的偏移量**目前是厂商默认值，不是本车实测值**。
参数格式是 `[x, y, z, roll, pitch, yaw]`（米 / 弧度）：

```yaml
base_to_laser: [...]     # ★ 雷达位置错了, 建图和定位全错
base_to_link: [...]      # 底盘本体参考面离地高度
```

**量测基准**：`base_footprint` = **两个驱动轮触地点的中点在地面的投影**
（不是车体中心，也不是轮轴上方）。

其它已知量：**轮距（左右轮触地点间距）930 mm**，**轮周长 0.644 m**
（实测 2 m ÷ 3.1 圈 = 0.645 m，吻合）。
⚠ **URDF 里的 `senior_diff` 尺寸是错的**（轮距 2×0.1815 = 0.363 m，而实际
930 mm）。它**只影响 RViz 显示**，不影响里程计（固件里用的是 930 mm）——
但你在 RViz 里看到的机器人形状和真实大小对不上，别被它误导。

### 6.4 本车扩展：滚刷 / 水泵

`/chassis_relay`（`std_msgs/UInt8`，bit0 滚刷 bit1 水泵）—— 固件里滚刷和水泵都
**只能显式开关**，不会自动起。底层是自定义的 `f[1]=0x05` 帧，靠厂商节点转发
（补丁见 `vendor-patches/chassis_relay_vendor.patch`）。

---

## 7. 还没测 / 不确定的（诚实清单）

| 项 | 状态 |
|---|---|
| **端到端延迟**（`/cmd_vel` → 车动、以及 `/odom` 的滞后） | **没测**。已知源侧时序：STM32 CAN 周期 20 ms、遥测 50 ms（所以 `/odom` 源数据本身最多旧 50 ms） |
| **原地转精度**（外环加了"线性带"之后） | **没重测**（v2 的数据见 §2.2） |
| **距离刻度的权威值** | 只有 1 m 的测量（且被滑行污染），**需要 4 m 以上重测** |
| `vx=0.30` 的均值 | 两趟分别 92% / 99%，**离散度没搞清**；怀疑与电池电压有关（实测 `bat` 从 26.9V 掉到 22.8V 时表现变差） |
| **电池** | **实测掉到 22.8V**（驱动峰值电流 7~11A）。电压低时驱动器表现会变差 → **建议充满再标定/评估** |
| **雷达** | **未安装** → **SLAM / Nav2 目前无法工作**（它们唯一的环境输入就是激光） |
| 传感器外参 | 厂商默认值，**未实测**（§6.3） |
| 固件实验分支 | `pos-mode`（位置模式）在另一条分支上，**未验证**，不要用在 main 上 |

---

## 8. 可用工具（都在 `tools/`，部署在车的 `~/chassis_tools/`）

| 工具 | 干什么 |
|---|---|
| `straight_quality.py VX DUR` | **直线质量**：用 IMU 当偏航真值，量化"忽快忽慢"和跑偏；含 IMU 死活自检和 `/cmd_vel` 污染自检 |
| `turn_truth.py WZ DUR` | **原地转真值**：同时记录 `/odom`、`/odom_combined`、`/imu/data_raw`，逐秒角速率 |
| `turn_sweep.sh` | 原地转对 `wz` 扫一遍（4 个点），看低速区有多坏 |
| `chassis_check.py` | 验收：`--once VX`、`--drive-to 米`、`--turn-only`；自带就绪等待和污染自检 |
| `decode_diag.py` | **直读串口**看 STM32 内部状态（驱动器电流/故障码/模式/目标 vs 实际）。**串口是独占的，要先停 ROS 底盘节点** |
| `chassis_bringup.sh` | `start|stop|restart|status` |
| `chassis_watchdog.sh` | `/odom` 停发就重启栈（systemd: `chassis-watchdog.service`） |
| `chassis_web.py` | 网页监视 + 手动控制：`http://<车IP>:8080`。⚠ 点"使能"后它会接管 `/cmd_vel` |

**两个使用纪律**（都是踩过坑总结的）：

1. **测量前先确认 `/cmd_vel` 上没有别人在发**。工具会自检，但手工测试时自己也要看一眼。
2. **`decode_diag` 需要独占串口**，跑之前先 `touch /tmp/chassis_watchdog.pause`
   暂停看门狗、停掉 ROS 栈，跑完 `rm` 再起栈。

---

## 9. 更深的细节在哪

| 想了解 | 看 |
|---|---|
| 底盘串口协议（11 字节命令帧 / 24 字节遥测帧） | `docs/chassis-serial-protocol.md` |
| 接线、引脚、IMU 为什么用软件 I2C | `docs/wiring.md` |
| ROS 接入的完整过程、踩过的坑、工作包线 | `docs/ros-integration.md` |
| 固件设计、继电器、外环修正、诊断帧 | `README.md` |
| 位置模式实验（另一分支） | `docs/pos-mode.md` |
