SkyHao723/sweeper_chassis/tools/chassis_web.html

# 底盘数据

连接中… — — 导出前 30 s（CSV）

## 运动控制

前

后

左

右

使能（必须先点） 急停 / 空格

最高前进 — m/s

最高转向 — rad/s

读取中…

键盘：W/S 前后 · A/D 左右转 · 空格 急停（都要按住）。 松手、鼠标移出、切到别的标签页都会立刻停车。

## 前进达成率

—

/odom 实测 ÷ /cmd_vel 命令

## 转向达成率

—

/odom 实测 ÷ /cmd_vel 命令

## 航向差（相对打开页面时）

—

EKF 与轮速里程计分开了多少 —— 几乎不动 = IMU 没起作用

## 命令 vs 实测

量 | 命令 | /odom 轮速 | /odom_combined
vx (m/s) | — | — | —
wz (rad/s) | — | — | —
位置 (m) | — | — | —
偏航 (°) | — | — | —

## IMU 与电池

量 | x | y | z
陀螺 (rad/s) | — | — | —
加速度 (m/s²) | — | — | —

电池 — V

## 前进速度 (m/s)

命令 /odom 轮速 /odom_combined

## 转向角速度 (rad/s)

命令 /odom 轮速 /odom_combined

## 轨迹 (俯视, 上=车头朝向的起点)

/odom 轮速 /odom_combined (EKF) 点 = 当前位置

## 超声波 (m)

空 = 没量到(inf/0), 不是 0 米

## 话题健康

话题 | 频率 | 最后收到
