SkyHao723/sweeper_chassis/firmware/stm32-chassis/hardware/YbImu.h

#ifndef YBIMU_H
#define YBIMU_H

#include "stm32f10x.h"

/*==========================================================================
 * 亚博 (Yahboom) YbImu 姿态传感器 —— I2C 接口
 *
 *   SCL = PB10      SDA = PB11      从机地址 0x23
 *   VCC 必须接 3.3V (模块的 I2C 上拉通常拉到它自己的 VCC 上, 给 5V 会灌进 IO)
 *
 * 寄存器 (1 字节地址, 数据小端):
 *   0x01 版本号          3 字节
 *   0x04 原始加速度      6 字节  int16×3, 单位 g,   满量程 ±16g
 *   0x0A 原始角速度      6 字节  int16×3, 单位 rad/s, 满量程 ±2000dps
 *   0x10 原始磁力计      6 字节  int16×3, 单位 uT,  满量程 ±800uT
 *   0x16 四元数         16 字节  float×4
 *   0x26 欧拉角         12 字节  float×3, 单位 rad
 *
 * 用软件(位翻转) I2C, 不用 STM32 的硬件 I2C 外设:
 *   STM32F103 的 I2C 有已知 errata 会死锁, 标准库的 I2C_CheckEvent 又是
 *   无超时的忙等 —— 一旦卡住整个固件就挂了。位翻转没有状态机, 好调也好救。
 *========================================================================*/

#define YBIMU_I2C_ADDR      0x23
#define YBIMU_REG_VERSION   0x01
#define YBIMU_REG_ACCEL     0x04    /* 6 字节 int16×3, 单位 g,     满量程 ±16g  */
#define YBIMU_REG_GYRO      0x0A    /* 6 字节 int16×3, 单位 rad/s, 满量程 ±2000dps */
#define YBIMU_REG_MAG       0x10    /* 6 字节 int16×3, 单位 uT,    满量程 ±800uT */
#define YBIMU_REG_QUAT      0x16    /* 16 字节 float×4 (w,x,y,z) */
#define YBIMU_REG_EULER     0x26    /* 12 字节 float×3 (roll,pitch,yaw), 单位 rad */

/* ★ 加速度和角速度分两次读, 各 6 字节 —— 和厂商的参考实现
 *   (IMU_I2C_ReadAccelerometer / IMU_I2C_ReadGyroscope) 一致。
 *
 *   历史: 曾经把"角速度恒为 0"归因于"一次读 12 字节, 地址指针不跨功能块
 *   自增"。**那个归因很可能是错的** —— 实测发现这颗模块**在检测到静止时
 *   本来就把角速度输出归零**(静止 478 帧全零, 转动 321 帧都有数据),
 *   所以当时看到的"陀螺仪恒 0"多半只是"读的时候没动它"。
 *   两次读继续保留(和厂商一致, 没有坏处), 但别再把 12 字节读当成故障原因。 */

/*------------------------- 诊断状态码 ---------------------------*/
#define YBIMU_ST_OK         0   /* 正常 */
#define YBIMU_ST_SCL_LOW    1   /* 空闲时 SCL 不是高 —— 缺上拉 / 没接 / 对地短路 */
#define YBIMU_ST_SDA_LOW    2   /* 空闲时 SDA 不是高 —— 缺上拉 / 没接 / 对地短路 */
#define YBIMU_ST_BUS_DEAD   3   /* 起始条件失败, 总线被别人拉着 */
#define YBIMU_ST_NO_ACK     4   /* 地址 0x23 不应答 */
#define YBIMU_ST_READ_ERR   5   /* 地址应答了但数据阶段出错 */

/* 6 号以前是 YBIMU_ST_GYRO_ZERO("加速度正常但角速度恒为 0")。
   **那个判定是错的, 已删除**(见 YbImu.c 里 YbImu_ReadMotion 的说明):
   模块静止时角速度本来就输出 0, 那不是故障。单看一瞬间也分不出"坏了"和
   "正好静止" —— 判断陀螺仪死活只能靠"动一下看数值变不变"。
   不要把这个码加回来。 */

/* 读一次运动数据。返回 YBIMU_ST_OK 或 YBIMU_ST_* 失败码。
   注意: 静止时角速度会是 0, 这是模块的正常行为, 不是失败。 */
uint8_t YbImu_ReadMotion(float accel_g[3], float gyro_rad_s[3]);

/*------------------------- 寄存器体检 ---------------------------
 * 把每个功能块都读一遍, 看哪些有非零数据。
 *
 * 用途: 角速度恒为 0 时, 只靠 0x0A 一个寄存器分不清是
 *   (a) 只有陀螺仪这一块坏了, 模块其它部分还活着
 *   (b) 整个模块只剩加速度能用(比如进了某种受限模式)
 * 两种情况的修法完全不同, 所以必须能区分。
 *
 * 顺带把模块内部融合出来的偏航角读回来 —— 万一原始陀螺仪真读不出来,
 * 这个还能当角速度的替代来源(对时间求导)。
 *----------------------------------------------------------------*/
typedef struct
{
    uint8_t ver[3];       /* 0x01 版本号 */
    uint8_t ver_ok;       /* 版本号读到了 */
    uint8_t gyro_ok;      /* 0x0A 读到非零 */
    uint8_t mag_ok;       /* 0x10 读到非零 */
    uint8_t quat_ok;      /* 0x16 读到非零 */
    uint8_t euler_ok;     /* 0x26 读到非零 */
    float   euler_yaw;    /* 0x26 的偏航角 rad (仅 euler_ok 时有效) */
} YbImu_Probe_t;

void YbImu_Probe(YbImu_Probe_t *out);

/*----------------------------- 诊断 -----------------------------*/
uint8_t YbImu_BusCheck(void);   /* 返回 YBIMU_ST_* : 只看总线空闲电平和起始条件 */
uint8_t YbImu_Scan(void);       /* 扫 0x08~0x77, 返回第一个应答的地址, 0 = 没扫到 */
uint8_t YbImu_ReadVersion(uint8_t out[3]);

/* 底层, 一般不用直接调 */
uint8_t YbImu_ReadRegs(uint8_t reg, uint8_t *buf, uint8_t len);

#endif
