SkyHao723/sweeper_chassis/firmware/stm32-chassis/hardware/LED.c

#include "stm32f10x.h"                  // Device header

void LED_Init (void) {
	RCC_APB2PeriphClockCmd (RCC_APB2Periph_GPIOA, ENABLE);
	
	GPIO_InitTypeDef GPIO_InitStructure;
	GPIO_InitStructure.GPIO_Mode = GPIO_Mode_Out_PP;
	GPIO_InitStructure.GPIO_Pin = GPIO_Pin_1 | GPIO_Pin_2 ;
	GPIO_InitStructure.GPIO_Speed = GPIO_Speed_50MHz;
	GPIO_Init (GPIOA, &GPIO_InitStructure);
}
