SkyHao723/sweeper_chassis/(commit log)

2026-09-20 chore: 初始化仓库, 规范化目录结构
    把工作区整理成标准布局:
    firmware/stm32-chassis/ STM32 底盘控制器 (原 1/)
    firmware/esp32-web-host/ ESP32 网页遥控 (原 ESP32_DEBUG_WEB_ARDUINO/)
    docs/ 接线/协议文档
    同时:
    - Keil 工程改名 stm32-chassis, 输出名不再是 1
    - 新增 .gitignore 排除构建产物
    - STM32 双串口 (USART1 主口给 RK3588, USART2 从口给 ESP32) + 控制权仲裁
    - EKF 可用 EKF_ON_STM32 开关, 便于移交给上位机
2026-09-20 feat(imu): 接入亚博 YbImu, 并修正与底盘协议的偏差
    协议一致性修正 (以 docs/chassis-serial-protocol.md 为准)
    - STM32: 忽略协议里的非速度帧功能帧 (灯带 0x04 / 回充开关 / 安全防护)。
    这些帧与速度帧同为 11 字节、同头同尾, 原来会被当速度帧解析,
    f[3..8] 被误读成 vx/wz, 车会乱窜。
    - ESP32: 拼帧改成 MD 第 5 节的规则 (上一字节是帧尾、本字节是帧头才入帧),
    与厂商驱动保持一致。原来见到帧头就入帧, 会造成 ESP32 能跑但 RK3588 跑不了。
    - ESP32: 真正模拟 RK3588 —— 自己用 (vx,vy,wz) 按 MD 5.2 节积分里程计,
    不再依赖 STM32 的位姿帧; 并解析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
    [YbImu.c, YbImu.h, main.c]
2026-09-20 feat: 拆分生产/调试两个固件版本, 并移除会导致失控的位置锁位
    == 两个版本, 一份源码 (CHASSIS_RK3588_ONLY) ==
    生产版 stm32-chassis-rk3588.uvprojx
    只初始化 USART1 (PA9/PA10 -> CH340/RK3588), 完全不碰 ESP32;
    不做本地 EKF (EKF_ON_STM32=0, 交给 RK3588); 不发 0x7E 扩展帧。
    Code 9548 B。
    调试版 stm32-chassis.uvprojx
    双串口 + 控制权仲裁 + 本地 EKF + 0x7E 里程计帧 (给 ESP32 网页)。
    Code 14388 B。
    两个工程的输出目录分开 (Objects/ 与 Objects-rk3588/), 来回切换烧录
    不会破坏对方的增量编译结果。两版均 0 Error / 0 Warning。
    == 移除位置锁位 (本次重点) ==
    原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
    [main.c]
2026-09-20 refactor!: 与 ESP32 彻底脱钩, 只留一个固件; 扩展帧改为纯诊断帧
    == 背景 ==
    ESP32 网页遥控当初只是临时上位机替身, 现在确定以后不再使用。
    它在仓库里牵着一整条链路(STM32 的 USART2/PA2-PA3、双口控制权仲裁、
    本地 EKF、专门的"调试版" Keil 工程), 全部删除。
    == 删除 ==
    - firmware/esp32-web-host/ (Arduino 网页遥控工程)
    - STM32: USART2_Init / USART2_IRQHandler / PORT_AUX / ports[2]
    - STM32: 控制权仲裁 (ctrl_owner / OWNER_TIMEOUT_MS / 抢占与续期逻辑)
    - STM32: 本地 EKF 整块 (Ekf_Init/Predict/UpdateWheel/UpdateGyro、
    WrapPi、IMU_ReadGyroZ、PutI32、EKF_* 噪声参数)。定位在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
2026-09-20 fix: 电机继电器上电后自动合闸, 否则换成 RK3588 当上位机后车根本不会动
    继电器帧(f[1]=0x05)是本工程自定义的扩展, **厂商 ROS 节点不认识、永远不会发**。
    而 Relay_Init() 上电是 Relay_Set(0) 两个继电器全断, 于是:
    电机继电器一直断开 -> 电机没电 -> 轮子不转
    但 STM32 照样发 CAN 转速命令, 驱动器回码「目标有、实际 0、电流≈0」
    这个现象和「驱动器没给力」在诊断上**完全分不出来**, 能白白查很久。
    之前能动只是因为当时用 ESP32 网页手动合过闸; ESP32 退场后就没有任何东西
    能合这个闸了。
    改成: 收到第一条有效命令时自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
    [decode_diag.py, main.c]
2026-09-20 fix(tools): 电流标定少算 10 倍 (A×10 不是 A×100), 并加电池电压
    == 电流标定 (重要) ==
    协议第 5 页原文: "DATA4 当前输出扭矩电流 int16 A ... 放大10 倍，保留1 位小数";
    力矩模式命令那边也写着 "写入 -100~0~100 对应 -10.0A~0~10.0A"。
    两处都说明是 A×10, 而解码脚本按 A×100 除了 —— **所有电流都少算 10 倍**。
    后果很实际: 地面跑 0.2m/s 时真实电流是 4.0A/6.2A、峰值 10.4A,
    却显示成 0.4/0.6A, 差点把"电机在使劲但被卡住"误判成"驱动器没给力"。
    CUR_EPS 判定阈值同步从 30 改成 10 (=1.0A)。
    == 加电池电压 ==
    主遥测帧(24B) [20-21] 是电池电压。带载电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
    [decode_diag.py]
2026-09-20 chore: 三个 -rk3588 残留文件移出 git 索引 (Keil 占着, 磁盘上删不掉)
    b0e6816 里已经 git rm 过这三个文件, 但当时 Keil 开着、文件被占用,
    git 只把它们从索引里去掉、没能从磁盘上真正 unlink(同一个原因也让当时
    删空目录报了 "being used by another process")。之后 2bacaef 用
    git add -A 时, 它们又躺在磁盘上被收了回来。
    现在先 git rm --cached 把它们摘出索引。磁盘上的文件要等 Keil 关掉才能删。
    顺带确认了一件要紧事: Objects/ 和 Objects-rk3588/ 两个 hex 都是 30447 字节,
    而 main.c 的最后修改时间早于两者 —— 说明两个工程编出来的确实是同一份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
2026-09-20 feat(imu): 寄存器体检 + 诊断帧扩到 36 字节; car_mode 已确认要改
    == 为什么加体检 ==
    IMU 陀螺仪读出来恒为 0, 但加速度完美(z=9.78 m/s²) —— 说明 I2C 总线、从机
    地址、供电都没问题, 坏的只是 0x0A 这一个功能块。可光看 0x0A 一个寄存器,
    分不清是:
    (a) 只有陀螺仪这块坏, 模块其它部分还活着
    (b) 整个模块进了受限模式, 只剩加速度能用
    这两种情况的修法完全不同。
    之前驱动**从来不读 0x04/0x0A 以外的任何寄存器**, 所以查不下去。
    现在 1Hz 把每个功能块读一遍, 只看"有没有非零字节":
    0x01 版本 / 0x0A 陀螺 / 0x10 磁力 / 0x16 四元数 / 0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
    [YbImu.c, YbImu.h, decode_diag.py, main.c]
2026-09-20 feat(tools): 底盘验收脚本 chassis_check.py (命令值 vs /odom 实测)
    "底盘做好没有"需要一个可重复的判据, 否则每次改完只能凭感觉。
    这个脚本走 ROS: 发 /cmd_vel, 用 /odom 核对, 不碰串口, 所以可以和
    厂商底盘节点 + EKF 同时跑(它们占着串口)。
    每个用例报四个数, 把"起步慢"和"稳态不准"分开 —— 这两件事的修法完全不同:
    全程比例 = 整个测量窗的平均速度 / 命令值
    稳态比例 = 窗口后 40% 的平均速度 / 命令值
    到80%用时 = 瞬时速度首次达到命令值 80% 的时刻
    横漂/航向 = 直线跑偏和转向的绝对量
    实测结论(轮子着地, 4 条直线 + 2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
2026-09-20 fix(imu): I2C 出错路径漏发 STOP 导致总线卡死; 加总线恢复
    == 现象 ==
    给 IMU 加寄存器体检(读 0x16 十六字节 / 0x26 十二字节)之后, IMU 诊断码从
    "陀螺仪恒 0"变成了"总线死"(YBIMU_ST_BUS_DEAD), 而且**永不恢复**。
    诊断码能走到 BUS_DEAD 而不是 SCL拉不高/SDA拉不高, 说明两条线空闲时都是
    高电平(有上拉、没短路), 只是起始条件拉不起来 —— 典型的从机被上一次
    没结束的事务卡住、一直拉着 SDA。
    == 根因: 驱动本身有缺陷, 被长块读踩出来了 ==
    `YbImu_ReadRegs()` 有三条错误分支在 return 前**没有发 STOP**:
    - 第一段起始条件失败
    - repeated-start 失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
    [YbImu.c, main.c]
2026-09-20 fix(imu): 体检不再读 0x16/0x26 长块 —— 它把 IMU 搞成了"总线死"
    == 现象与时间线 ==
    加体检之前: imu=陀螺仪恒0 (加速度正常, 只有陀螺仪死零, 能正常用)
    加体检之后: imu=总线死 (YBIMU_ST_BUS_DEAD, 连加速度都读不到, 且不恢复)
    时间点和"开始读 16 字节长块"完全吻合 —— 为了诊断反而把器件搞死了, 比不
    做体检还糟。
    (中途我一度判断"开机就死、与体检无关", 那是错的: seq 是 uint8_t, 255 回绕
    到 0, 我把回绕当成了重启。STM32 其实一直没重启。)
    == 改法 ==
    体检只读 3/6/6 字节这些短块: 0x01 版本 / 0x0A 陀螺 / 0x10 磁力。
    一样能回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
    [YbImu.c]
2026-09-20 fix(tools): 体检显示不再谎报"四元数/欧拉 死"; 记录陀螺仪结论
    == 显示 bug ==
    保守版体检**故意不读** 0x16/0x26(读长块会把模块卡死, 见 YbImu.c), 但
    `probe_text()` 把这两个位报成了"死" —— 那是**没测**, 不是坏。
    分不清这两者会直接把人带偏(第一眼看到"四元数/欧拉都死了"会以为模块半废,
    实际上根本没查过)。现在只列真的读过的块: 版本 / 陀螺 / 磁力。
    用本车实测数据回放验证:
    imu=陀螺仪恒0[活:版本/磁力 死:陀螺 ver=1]
    == 本车 IMU 结论 (写进 README) ==
    加速度正常(z≈9.78)、磁力计正常、**只有陀螺仪三轴全为字面 0**(不是"静止
    所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
    [decode_diag.py]
2026-09-20 docs: 新增 docs/ros-integration.md, 固化底盘接入 ROS 2 的状态
    把这台车接进 ROS 2 的完整状态写下来, 免得下次重新摸:
    - 一句话启动 (主 launch, 四个组成部分各干什么)
    ★ 特别写明"别只起 base_serial.launch.py" —— 我自己一开始就是这么起的,
    结果没有 TF 树, Nav2/SLAM 什么都干不了, 白折腾一轮。
    - 冷启动验证结果: 8 个节点无重复 / /odom /odom_combined /imu/data_raw
    全部 20Hz / TF 树完整 / 日志无错误。
    - 本车改动过的地方:
    car_mode 从 senior_4wd_bs 改成 senior_diff (四驱 -> 两驱差速)
    ★ 传感器安装位置在 config/robot_model.yaml 的 base_to_laser/base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
2026-09-20 fix(imu)!: 删除错误的"陀螺仪恒 0"判定 —— 陀螺仪一直是好的, 是我们误报
    == 真相 ==
    转一下板子就清楚了。后台采集 799 帧:
    静止 478 帧 -> 三轴全部精确为 0
    转动 321 帧 -> 三轴都有真实数据, 量程内满幅
    gx -32768..+27635 (245/799 非零)
    gy -32767..+32767 (282/799 非零)
    gz -17736..+32767 (311/799 非零)
    **这颗 YbImu 在检测到静止时就把角速度输出归零。** 所以"三轴全零"是正常
    现象, 不是故障。
    == 错在哪 ==
    YbImu.h 里那句"真实陀螺仪静止时也有噪声"是**我拍脑袋写进去的假设, 毫无
    依据**。基于它造了 YBIMU_ST_GYRO_ZERO 这个"故障码", 然后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
    [YbImu.c, YbImu.h, decode_diag.py, main.c]
2026-09-20 docs: 手推标定里程计在本车无效 —— 被反拖时只有一路轮速上报
    == 实测证据 ==
    推 1 米, 后台采 2582 帧诊断帧(同时发零速喂狗), 其中 344 帧有轮速:
    341 帧 只有 1 号(左)有数
    3 帧 只有 2 号(右)有数
    0 帧 两路同时有数
    数值关系完全吻合:
    左实际 +6 -> vx=+32mm/s, wz=-69mrad/s
    验算 vx=(6+0)/2*10.73=+32 ✓
    wz=(0-6)*10.73/0.93=-69 ✓
    == 一个原因解释两个现象 ==
    路径长度 = (左+0)/2 -> 少一半 (实测 45%~55%)
    航向 = (0-左)/b -> 假转向 (实测 -68.6°)
    "走 0.55 米却算出右轮比左轮多走 1.11 米"物理上不可能, 所以必然有一路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
2026-09-20 fix(tools): 等 /odom 出现再判"收不到", 别 spin 1 秒就放弃
    现象: 用户跑 `chassis_check.py --drive-to 2.00` 得到 "收不到 /odom",
    但同一份代码我随后复现(小目标 0.05m)是好的, 最小订阅者测试也一直能收到。
    原因: CH340 偶尔掉线会让底盘节点崩掉(SerialException, exit -6), 而 launch
    里配了 respawn, 节点 2 秒后自己回来。**正好在那个窗口里启动脚本, 就会误报
    "收不到 /odom"** —— 让人以为是自己的问题。
    改法: 加 wait_for_odom(timeout=15s), 每 3 秒报一次进度, 超时后给出三条
    具体的排查命令(node list / fuser / topic echo)。drive-to 和多用例两条路径
    都用它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
    [chassis_check.py]
2026-09-20 feat(tools): chassis_bringup.sh —— 启动/停止/状态检查, 并兜住几个坑
    用户问"底盘节点怎么启动", 说明这套东西值得固化成脚本。
    ./chassis_bringup.sh start 启动(后台)并等到 /odom 真的有数据
    ./chassis_bringup.sh stop
    ./chassis_bringup.sh restart
    ./chassis_bringup.sh status
    关键点是**启动后要等到确认 /odom 出数据才算成功**, 而不是"进程起来了"。
    这套栈有三个"看起来像挂了其实没挂、看着没挂其实挂了"的坑:
    1. **节点进程活着、串口开着, 但不在 ROS 图里、也不发数据** ——
    多半是启动时串口被上一个残留进程占着, 厂商代码打不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
2026-09-20 fix(tools): bringup 的 stop 必须"杀完再验证" —— 漏杀会导致两份 launch 抢串口
    现象: 用户自己起了一份 `ros2 launch`, 我随后又用脚本起了一份。脚本的 stop
    只 pkill 了一遍, 用户那份**活了下来**, 于是两个 launch 抢同一个串口:
    节点日志开始崩溃循环: "serial port opened" -> SerialException -> exit -6
    -> respawn -> 再来, 一屏一屏地刷
    车跑测试时只走了 7.5cm 就停 (全程 4%), 而"0.15s 就到 80% 速度"
    两个数自相矛盾
    改法: stop_all() 先按模式 pkill, 再按 PID 兜 3 轮并**验证**有没有残留,
    有残留就打印出来。start 成功后再确认只剩一份 launch /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
2026-09-21 fix: ACCEL_STEP_MS 改回 0 (阶跃) —— 斜坡在拖后腿, 实测差 2~3 倍
    当初把 DATA4(加速间隔) 从 0 改成 3 是想让起步柔和、少顶过流保护,
    但**一直没做 A/B**。现在补上了, 实测对比 (同样一条 0.30m/s 直线):
    斜坡=3 (改之前) 斜坡=0 (现在)
    稳态速度 68%~137% 乱跑 86% (全程=稳态)
    到 80% 速度 0.15~0.80s 0.40s
    直线漂移 ~20°/m -5.4°/m (1.54m 偏 8.3°)
    **漂移改善约 4 倍**, 而且比更早的基线 (7.4°/m) 还好。
    机理猜测: 斜坡让驱动器的设定值缓慢爬升, 而驱动器速度环本身就在低频振荡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
    [main.c]
2026-09-21 fix: ROS_DOMAIN_ID 不一致 —— 一直误报"节点卡死/收不到 /odom"的真凶
    == 真凶 ==
    `ROS_DOMAIN_ID=5` 只写在 .bashrc 里, 而 .bashrc 顶部有:
    case $- in
    *i*) ;;
    *) return;;
    esac
    **非交互 shell 直接 return**, 所以 `ssh host '命令'` / 脚本 / systemd 服务
    跑的时候拿不到它, 用的是默认域 **0**。
    DDS 域不同 -> **两边互相看不见对方的话题**。这一个原因解释了最近一整串
    "故障":
    - 脚本报"收不到 /odom" 而节点明明活着 -> 栈在域5, 检查在域0
    - "节点卡死: 进程活着、串口开着、不发数据" -> 同上, 节点其实是好的
    - bringup start 起来就正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
2026-09-21 fix(tools): chassis_check 的期望值算错了窗口 —— "全程比例"凭空低 30%
    SETTLE_S(=0.6s) 那段起步被排除在测量窗之外, 但期望值一直按整条命令的时长
    (dur) 算, 于是全程比例 = (dur-SETTLE_S)/dur = 70% 打底。0.6/2.0 就是白低 30%,
    而且脚本还一直打印"比稳态低说明起步慢", 完全是误导人的结论。
    改成按窗口时长 win = dur - SETTLE_S 算 exp_fwd / exp_dth。
    同时改进汇总输出:
    - 转向不再只报一个"稳态比例", 而是逐个列出 实测/期望/百分比
    - 加"左右对称性" —— 同样角速度、相反符号的两次转向, 幅度差得多就说明两轮
    出力不匀(速度环振荡的相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
    [chassis_check.py]
2026-09-21 docs: 固化实测工作包线, 并把这一路误判过的结论记下来
    新增 4.5 节「实测工作包线」(固件 ACCEL_STEP_MS=0):
    命令速度 稳态实测 每米漂移 评价
    0.15 m/s 64% -46°/m ❌ 又慢又偏
    0.30 m/s 103% -3.2°/m ✅ 最佳工作点
    0.50 m/s 134% -0.25°/m ⚠️ 很直但超速 34%
    后退 -0.20 83% +15°/m ⚠️ 偏慢
    原地左转 0.5 98% — ✅
    原地右转 0.5 85% — ✅ 左右差 13%
    结论: **导航速度限在 0.25~0.35 m/s** (这个区间速度 103%、漂移 -3.2°/m, 基本完美)。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
2026-09-21 fix(safety): 加独立看门狗 IWDG; 复位后第一时间刹车; 诊断不再阻塞控制
    == 为什么必须加 IWDG (最重要的一条) ==
    原来只有"软件看门狗" —— 在主循环里检查上位机多久没发命令。**但它本身就在
    主循环里**: 主循环一旦卡住, 软件看门狗也跟着停, STM32 就再也不发 CAN 命令。
    而 **FOC 驱动器没有命令超时**, 会一直执行最后收到的那条命令。所以最坏情况是:
    主循环卡死 -> STM32 静默 -> 驱动器保持最后的速度 -> **车自己开走**
    而 `Port_SendByte` 正是个无界等待:
    while (USART_GetFlagStatus(p->usart, USART_FLAG_TXE) == RESET) {}
    这条路径是真实存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
    [main.c]
2026-09-21 feat(safety): 诊断帧报复位原因 —— 看门狗到底触发过没有
    光加 IWDG 不够: IWDG 触发只会表现为"车莫名停了一下", 没有任何痕迹可查。
    STM32 的 RCC_CSR 里记着上次复位的原因, 读出来报给上位机就有据可依了。
    main() 开头读 RCC_FLAG_IWDGRST -> reset_by_iwdg, 然后 RCC_ClearFlag()
    (复位标志是掉电才清, 不主动清的话下次复位还报旧账)
    诊断帧 [1] 的 flags 新增 bit4 = "上次复位是 IWDG 引起的"; bits 5-7 还空着。
    (bit2/bit3 的含义也在帧注释里写清了: bit2 加速度有效, bit3 陀螺仪自开机以来
    读到过非零 —— 后者才是判断陀螺仪死活的正确指标。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
    [decode_diag.py, main.c]
2026-09-21 feat(tools): chassis_check 同时测 /odom 和 /odom_combined —— 之前只测了纯轮速
    == 为什么必须补这个 ==
    用户的目标是"让 EKF 融合后的数据尽量真实"。但我前面所有漂移数据都是
    **/odom（纯轮速积分，完全不含 IMU）** 的 —— chassis_check 只订阅了 /odom。
    厂商节点的位姿就是这么算的:
    Robot_Vel.X = Odom_Trans(rx[2],rx[3]); // 来自 STM32 的 vx
    Robot_Vel.Z = Odom_Trans(rx[6],rx[7]); // 来自 STM32 的 wz
    Robot_Pos.X += (Vx*cos(psi) - Vy*sin(psi)) * dt;
    Robot_Pos.Z += Vz * dt;
    **全程没有 IMU**。
    而 /odom_combined 是 EKF 输出, 权重配置是:
    odom_twist_covariance[35] = 5e-2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
2026-09-21 转向偏差查清: 是底盘执行问题, 不是融合问题; 并修掉看门狗误重启
    用 IMU 陀螺仪当独立参照, 查清了"原地转只到 43%"这个悬案。
    结论: /odom 的角速度就是 STM32 按轮速算出来的值, 厂商节点直接取用 —— 它和
    指令同源, 比值恒等于 1, 拿它验证它自己毫无意义。换 IMU 一对(左转, 4 秒窗口):
    /odom 81% /odom_combined 73% IMU 74%
    三者一致 -> 里程计是诚实的, 车是真的没转够。
    逐秒角速率显示: 起步要 1.5~2 秒, 第 2 秒过冲 22%, 最后稳在 88~98%;
    右转第一秒只有 13%(左转 44%), 左右不对称就是这么来的。原地转只要 ±21 RPM,
    正落在驱动器低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
    [turn_truth.py]
2026-09-21 feat(stm32): 轮速外环修正 —— 让底盘真的照命令走
    问题: STM32 的 Drive_Apply() 是纯开环, 算完目标轮速直接发给驱动器, 从不回读
    实际转速, 所以驱动器没做到位它也不知道。实测(原地转, wz 扫描):
    wz 单轮目标 第0秒 第1秒 第2秒 稳态
    0.30 13 RPM 5% 15% 89% 85%
    0.50 22 RPM 1% 29% 20% 115%
    0.70 30 RPM 10% 86% 121% 106%
    1.00 43 RPM 26% 106% 100% 96%
    ★ 即使目标高达 43 RPM, 第 0 秒也只有 26%; 而直线运动 0.07 秒就到 80%。
    同一个轮速区间差这么多, 所以这**不是**驱动器低速死区(这个判断一度写进文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
    [decode_diag.py, main.c]
2026-09-21 chore: build.log 是编译产物, 不进仓库 (加进 .gitignore)
2026-09-21 fix(stm32): 外环 v2 —— 比例限幅 + 慢积分 + 定时助推; 并修三个会毁掉测量的坑
    ## 外环 v1 的问题 (干净重测确认是真的, 不是数据污染)
    v1 = "纯积分 + 绝对限幅 ±30 RPM + KI=1.5"。四秒总角度确实从 41%~82% 提到了
    85%~98%, 稳态也从 115% 回到 101%, 但形状和安全性都不合格:
    wz=0.30 逐秒: 0.025 / 0.585 / 0.573 / -0.001 <- 第3秒归零 = 轮子被顶成反转
    wz=1.00 逐秒: 0.386 / 1.746 / 0.867 / 0.529 <- 第1秒过冲 175%, 然后一路衰减
    1. **绝对限幅在小名义值下会把指令顶成反向。** wz=0.30 的名义轮速只有 13 RPM,
    而修正量能到 -30, 于是 指令 = 13-30 = **-17**,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
    [chassis_check.py, decode_diag.py, main.c, turn_truth.py]
2026-09-21 fix(stm32): 助推改成"轮子一转起来就撤"; 并修 chassis_check 只改了一半的比例 bug
    ## v2 上车实测: 转向修好了, 直线被助推害了
    转向 (原地转 4 秒总角度, IMU):
    wz=0.50 41% -> 101% wz=0.70 81% -> 100%
    wz=1.00 82% -> 102% wz=0.30 49% -> 49% (低速档仍差)
    关键是**末端不再塌陷**: v1 最后 1 秒只有 14%~54%, v2 是 95%~99%。比例限幅 + 降 Ki
    正是要解决这个。第 1 秒还有 155% 过冲(助推造成), 但第 3 秒就收敛。
    直线反而变差: 稳态 67% / 144% / 155% (外环前是 64% / 103% / 134%)。
    而且三个用例都显示"命令后约 1.8 秒几乎不动, 然后以 144%~155% 冲出去"。
    ##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
    [chassis_check.py, main.c]
2026-09-21 docs+tool: 直线精度根因是驱动器速度环的极限环, 不是外环
    decode_diag --drive 0.30 0 逐帧数据 (目标 27.9 RPM 名义值):
    目标 +35 实际 +0 +7.80A
    目标 +36 实际 +62 +5.00A <- 实际跳到名义值 2.2 倍
    目标 +41 实际 +23 +8.00A
    目标 +31 实际 +52 +1.60A
    实际在 0~71 RPM 之间暴力振荡, 电流 7~11A。而外环自己只贡献几个 RPM
    (那个'修正+13'里 12 是助推, 积分只剩 1) -> 直线精度的根因在驱动器内部
    的速度环, 外环够不着这一层。
    顺便修一个会骗人的显示: decode_diag 那个字段是'积分修正 + 助推'的合计,
    原来标成'外环修正', 害我以为积分已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
    [decode_diag.py]
2026-09-21 feat(decode_diag): 解出加速度计 + 滚动峰峰值 —— 给'轮速到底是不是真在抖'当独立裁判
    驱动器回码在 0~71 RPM 之间暴力来回冲时, 有两种完全不同的可能:
    (a) 车真的在一窜一窜 -> 纵向加速度必然跟着摆, 幅度约 A = v_pp*pi*f,
    0.76 m/s 峰峰值 / 1Hz 也有 ±2.4 m/s^2;
    (b) 只是驱动器的转速估计在乱跳, 车其实走得很顺 -> 加速度是平的,
    只剩路面噪声(约 0.1~0.3 m/s^2)。
    加速度计和轮速完全独立, 所以这一眼就能定性 —— 而两种情况的修法完全不同:
    真在抖要改控制(扭矩模式自己做速度环), 只是回码在抖则是滤波/估计的问题,
    而且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
    [decode_diag.py]
2026-09-21 fix(stm32): 继电器合闸后必须等两个驱动器回码才发速度命令
    实测: 同一条直行命令连发三次, 结果分别是**没反应 / 向左转 / 正常前进**。
    直行变左转说明那一次只有一个驱动器响应了。
    根因: **电机继电器负责给驱动器供电**, 而继电器在每次断链时都会断开
    (Ctrl-C 停上位机 -> 800ms 看门狗 -> Relay_Set(0))。所以每次重新开始发命令,
    驱动器都是刚上电、还在初始化 —— 初始化没完就发速度命令就不可靠。继电器每次
    重连都会重演, 放到导航里就是'偶尔不动、偶尔歪一下', 且完全不可复现。
    修法(等确认再动, 不是猜它能动):
    -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
    [decode_diag.py, main.c]
2026-09-21 fix: 继电器是滚刷/水泵, 和轮毂电机无关 —— 纠正命名与由此产生的错误推理
    用户指出: 车上是一个水泵 + 一个扫地滚刷电机 + 一对轮毂电机, **继电器只控制
    前两个**, 和轮毂电机没有任何关系。
    ## 错在哪, 为什么会错
    PB0 一直叫 RELAY_MOTOR / "电机继电器", 文档还写着"不合闸电机就没电"。
    那个"电机"被读成了**轮毂驱动电机**, 于是建立起一条看起来完全合理的链条:
    继电器给驱动器供电 -> 断链断电 -> 每次重连驱动器都在上电初始化 ->
    所以第一条速度命令不可靠。
    实际上继电器管的是**滚刷和水泵**, 轮毂驱动器是独立供电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
    [main.c]
2026-09-21 feat(stm32): 滚刷改成显式控制; 把看门狗拆成"运动超时"和"链路超时"两条
    按用户要求: 滚刷继电器不再跟着运动命令自动合闸, 和水泵一样只能由上位机显式发
    f[1]=0x05 帧控制 (f[2] 掩码: bit0 滚刷 bit1 水泵)。
    ## 为什么不能只删那个 if
    原来的断链保护是**一条** last_cmd_ms 同时管两件事, 而且继电器分支在 Cmd_Apply 里
    提前 return、根本不喂狗。所以"显式开滚刷"会在 800ms 后被断链保护自己关掉 ——
    显式控制根本没法用。
    拆成两条(它们本来就不是一回事):
    - **运动看门狗**: 800ms 没收到**速度帧** -> target 归零 + 刹车 (锁存)
    - **链路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
2026-09-21 feat(vendor): 给厂商节点加 /chassis_relay 转发通路, 让 ROS 能开关滚刷/水泵
    滚刷改成显式控制后, ROS 侧没有任何通路能开关它: 这条 f[1]=0x05 是本工程自定义
    扩展, 厂商 wheeltec_robot_node 不认识, 而它**独占串口** —— 别的进程写不进去。
    所以只能由厂商节点代为转发。
    ## 改动 (纯新增 0 删除, 补丁 vendor-patches/chassis_relay_vendor.patch)
    - src/wheeltec_robot.cpp: ChassisRelay_Callback / Send_Relay_Frame /
    Relay_Hold_Callback; 构造函数里注册订阅 + 200ms 定时器
    - include/.../wheeltec_robot.h: 订阅者/掩码/定时器成员, 三个方法声明,
    #include <chrono>
    帧格式和速度帧同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
2026-09-21 feat(tools): 只读数据网页 —— 局域网浏览器直接看底盘数据
    车里跑一个 systemd 服务 (chassis-web, 已 enable 开机自启), 浏览器打开
    http://192.168.5.17:8080 就能看。两个文件: chassis_web.py (服务端) +
    chassis_web.html (界面), 都在 tools/ 下, 也部署在 ~/chassis_tools/。
    ## 两个刻意的取舍
    1. **只读, 没有任何发速度的入口。** 这台车因为控制层的 bug 真失控过。一个能从
    浏览器点着走的东西要负责急停/指令超时/权限/误触 —— 那是另一个东西, 不该混进
    数据前端里。想看数据和想开车是两件事。
    2. **只用标准库, 不装任何包。** 板子上没有 fla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
    [chassis_web.py]
2026-09-21 feat(tools): 网页加运动控制 —— 照"绝不允许'浏览器不发了车还在走'"设计
    ## 三层兜底, 任何一层单独失效车都会停
    浏览器: 松手/移出/松键/切标签页/失焦/空格/急停 -> 立刻 POST 停车
    服务端: 浏览器 0.5s 没发心跳 -> 立刻**补发 8 帧零速**再闭嘴
    STM32 : 0.8s 收不到速度帧 -> 运动看门狗停车
    中间那层的"补发"是必须的, 不是保险起见: 如果只是沉默, STM32 要等它自己 800ms
    看门狗才停 —— **那 0.8 秒车还在按最后一条命令走**。这是死手设计里最容易漏的缝,
    而且我第一版就漏了(stop_burst 只在 set_arm/set_stop 里置位, 超时路径没有),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
2026-09-21 feat(tools): straight_quality.py —— 量化"忽快忽慢"和"跑偏", 不用卷尺
    用户反馈: 前进长度已经很接近(说明刻度没问题, 那 11% 里绝大部分确实是停车滑行),
    但偏航差 20~50, 而且走的时候忽快忽慢。
    这两件事很可能是同一个根因:
    驱动器速度环欠阻尼 -> 实际轮速过冲/回落(忽快忽慢)
    -> 左右两轮振荡不同步 -> 瞬时 (v右-v左) 非零 -> 车来回偏
    **而且外环的积分是逐轮的, 吃到的反馈正是这个振荡**: 某轮过冲时那一路修正量会被
    压到 -50% 限幅(名义 27.9 -> 指令掉到 14), 车慢下来; 修正量慢慢退回, 车又快起来。
    这可能就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
    [straight_quality.py]
2026-09-21 fix(tools): straight_quality 加 IMU 死活自检 —— 死的 IMU 会报出"完美直线"
    背景: STM32 静默那件事查到最后, 发现 IMU 是彻底死了 —— decode_diag 15 秒
    299/299 帧都是 imu=无应答, 加速度/陀螺全零, flags 的 bit2/bit3 都没置上。
    状态码 4 = YBIMU_ST_NO_ACK = 地址 0x23 不应答, 而**总线本身是好的**
    (不是 1/2/3 -> 没有 SCL/SDA 被拉死、起始条件也正常)。
    这直接推翻了我上一轮"IMU 卡死导致主循环挂住所以一帧遥测都发不出来"的猜测:
    总线没被拉住, 那不是"卡住", 是"没人应答"。
    而且它大概率就是用户报的"偏航差 20-50"的真正原因: EKF 的偏航几乎全靠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
    [straight_quality.py]
2026-09-21 fix(decode_diag): 峰峰值丢掉不可能的样本 —— 上电全 0 帧会污染成 9.7 并误报'车在窜'
    加速度计永远读到重力, 模长不可能接近 0。STM32 刚上电还没读到 IMU 时会发全 0,
    那几帧进 acc_hist 后, 每一次开头的'加速度峰峰值'都会打出 z=9.70 —— 看着像
    '车在一窜一窜', 其实是启动残值。实测被它骗过。
    判据用 L1 范数(>1.0) 即可, 不必引入 math。
    [chassis_web.py, decode_diag.py]
2026-09-21 feat(tools): 网页加"导出前 30 秒数据" (CSV)
    页面右上角按钮, 或直接开 /api/export.csv。23 列 / 20Hz / 600 行 ≈ 正好 30 秒。
    时间 · 命令vx·轮速vx·EKFvx·前进达成率 · 命令wz·轮速wz·EKFwz·转向达成率 ·
    轮速x/y/偏航 · EKFx/y/偏航 · 航向差(相对本表首行) · 陀螺xyz · 加速度xyz · 电池
    ## 几个刻意的选择
    - **CSV + UTF-8 BOM, 不是 xlsx**: .csv 不用装库就能双击进 Excel; 而 **BOM 不能省**
    —— 不带的话 Windows 版 Excel 按本地代码页解, 中文表头直接乱码。行尾 CRLF。
    - **命令相关 4 列在没人发 /cmd_vel 时是空的, 不填 0** —— 空和"命令是 0"是两回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
2026-09-21 fix(tools): 污染自检别只看发布者数量 —— 会误杀正常测量
    用户刚重启 RK3588、什么都没启动, straight_quality 就报
    "!! /cmd_vel 上有 2 个发布者 —— 数据不可信, 已中止"。
    查下来是我误报: chassis-web.service 是 **enabled 开机自启**的, 它一启动就
    create_publisher("/cmd_vel") —— 但 **chassis_web.py 的设计里明确写了只在
    "使能 + 心跳新鲜"时才真发**("否则本页面 20Hz 的零速会和 Nav2 抢 /cmd_vel,
    车会一抖一抖")。所以那第 2 个发布者是**完全静默**的, 按数量判断等于平白无故
    中止一次本来正常的测量。
    讽刺的是: chassis_web.py 早就把"两个源抢 /cmd_v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
    [chassis_check.py, straight_quality.py, turn_truth.py]
2026-09-21 fix(stm32): 外环积分加线性带 —— 抓到了"忽快忽慢"的元凶, 就是外环自己
    用户跑 decode_diag --drive 0.30 0 抓逐帧数据, 在"目标-理论"那一列(开局 400ms
    助推超时退出后它就是积分)直接看到了外环自己:
    seq=24 +7 -> seq=35 +13(贴住比例限幅 +13.95) -> +12 -> +9 -> +5 -> 0
    第二趟更完整: +13 -> 0 -> -7 -> 0 -> +6 -> ...
    周期约 4~5 秒 = 0.2~0.25Hz, **和 straight_quality 测出来的速度振荡 0.25Hz 完全
    吻合**; 振幅就是比例限幅本身(±50% 名义值 = ±14 RPM, 指令在 14~42 之间摆)。
    机制: 起步时轮子没转 -> 误差 20~28 RPM -> 积分一路顶到 +50% 限幅 ->
    指令 1.5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
    [main.c, straight_quality.py]
2026-09-21 fix(tools): straight_quality 同时报 IMU 零偏和噪声标准差
    用户实测确认外环线性带生效: 目标-理论 从'摆 ±14 RPM 并贴限幅'变成'全程 ±1 RPM',
    0.25Hz 极限环消失, 均值仍 ~100%。剩下的一次过冲(138%, 3 秒退回)是驱动器自己的
    阶跃响应 —— 它发生时 目标-理论 是平的, 外环没参与。
    日志里还露出一个更值钱的东西: 行驶中陀螺仪大多数帧都在输出 ±0.27~0.55 rad/s
    的尖峰(-1023/-2047/+1967 之类), z 轴加速度峰峰值 2.5 m/s^2, 是真实振动。
    而厂商给 EKF 的 angular_velocity_covariance[8]=2.5e-3(标准差 0.05), 小一个数量级,
    IMU 的拒绝阈值 100σ 也拦不住 -> 每个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
    [straight_quality.py]
2026-09-21 fix(tools): 用稳健统计代替峰峰值 —— 单帧残值会骗过 min/max 和振荡频率
    用户实测: 修完线性带后 5~95% 那批数字看似还大(峰峰值 139%、主振荡 0.65Hz),
    但逐秒已经变成'起步低 -> 一次过冲 0.402 -> 稳定在 0.25~0.32', 不是反复冲了。
    查下来是统计口径被单帧残值污染: 范围 min = 0.000, 而那个 0 几乎肯定是驱动器
    回码超过 RPM_STALE_MS(200ms) 时固件把'实际转速'当成 0 上报的**残值**, 不是车
    真停了。它同时撑大了 min/max/标准差, 并且——因为频率估计是数'均值穿越次数'——
    把主振荡频率也带偏了(0.65Hz 多半是假的)。
    改法:
    - stats() 增加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
    [straight_quality.py]
2026-09-22 docs: 新写 nav2-reference.md —— 给做 Nav2 定位/导航的同事的接口与精度参考
    用途: 把这台底盘"能给什么、不能给什么、哪些数字可以直接引用"一次说清, 让
    做导航的人不用去翻固件和一堆踩坑记录。全部数字都是实车实测, 并注明测量条件。
    内容:
    0. 一页速查 (含最容易踩的三条)
    1. 话题与坐标系 —— 话题表 / **TF 树** / /cmd_vel 语义
    2. 实测精度 —— 直线、原地转、距离刻度, 带测量方法
    3. ★ 速度包线 (配 Nav2 参数看这节)
    4. EKF 现状 —— 配置、偏航几乎全靠 IMU 且无绝对参照、IMU 噪声比假设略大
    5. 已知故障模式与症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
2026-09-23 fix(firmware): 起步助推按缺口给量 + 两轮共享判决, 修掉'小转向愣住'和'转向太敏感'
    实车报的两个症状是同一个根因的两端:
    小命令愣在原地 -- 助推是 400ms 一次性定时, 超时即撤, 目标没回零就不会重新武装
    转向太敏感 -- 助推是固定 +12 RPM 加性量, 原地转时等效额外 +0.28 rad/s,
    而且每次起步都给满 400ms
    第四版三条改动:
    1. 判'动没动'改用绝对转速(KICK_STILL_RPM/KICK_MOVING_RPM), 不看名义值比例。
    要破的是静摩擦, '轮子转没转'跟命令多大无关。
    2. 助推量按缺口给: clamp(15 - 最小|名义轮速|, 0, 20)。于是 |wz|>=0.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
    [decode_diag.py, main.c]
2026-09-23 feat(tools): 加 field_diag.sh —— 一条命令定位'RK3588 控制不了车'断在哪一层
    这次排查'控制不了'花了不少来回, 值得固化下来。四层可能, 从下往上一次查完:
    A 串口/USB 层: CH340 掉了/设备号变了/端口被别人占着
    B STM32 层: 没在跑, 或没在发
    C 命令链: /cmd_vel 有没有真的发出去, 有没有多个发布者在打架
    D 执行层: ★ 最容易漏的一层 —— 驱动器没上电/CAN 不通时, 固件会按就绪联锁
    **只发刹车**, 车当然不动, 而 /odom 和 /imu 一切正常。
    这时只从 ROS 侧看会误判成软件问题。
    D 层用固件自己的诊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
2026-09-23 docs: 写清'指令保活'——本车不保持最后一条命令, 以及键盘 teleop 为什么难开
    用户问'以前的车发一次前进0.5就不发也一直走, 咱们是啥样的'。答案是**不一样**:
    800ms 收不到速度帧, STM32 就把目标归零并刹车, 而且锁存(诊断帧 flags bit1)。
    代码在 main.c 的 LINK_TIMEOUT_MS 那一段。厂商节点自己没有 cmd_vel 超时
    (Cmd_Vel_Callback 里是收到就写串口, 没有定时器), 所以这 800ms 是唯一的死手。
    顺带把'手感很差'的一个主因查实了 —— 车上装的 teleop_twist_keyboard 2.4.1
    在 Linux 下是**阻塞**读一个字符(sys.stdin.read(1), 没有超时), 而且**每按一次键
    只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
2026-09-28 feat(firmware): PB9 加上电心跳灯 (2Hz 闪烁, 非阻塞)
    要求: 上电后在 PB9 上接的灯来回闪。
    选 PB9 前先查了全片引脚冲突, 结论是干净:
    - CAN1 走 PA11/PA12, **没有重映射**, 所以 PB8/PB9 本来就不是 CAN 脚
    (PB9 只有在 CAN1 重映射时才当 TX);
    - USART1 走 PA9/PA10, IMU 软件 I2C 走 PB10/PB11, 继电器是 PB0/PB1;
    - PB9 不在 JTAG 那五个脚里 (JTAG = PA13/PA14/PA15 + PB3/PB4), 不需要重映射。
    另外确认不会被别人踩掉: YbImu.c 只对 PB10|PB11 调 GPIO_Init, 而 SPL 的
    GPIO_Init 是读-改-写、只动掩码里那几个 nibble; 位翻转用的是
    GPIO_SetBits/ResetBits (BSRR/BRR 原子写), 也碰不到 PB9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
    [main.c]
2026-10-10 docs: 写清零速命令的语义, 以及 SecurityPLY/AutoRecharge 非 0 会丢掉所有速度帧的坑
    问题: 底盘能不能识别 cmd_vel 0?
    答案: 能, 而且是一等公民。vx=0,wz=0 是合法速度帧, STM32 会喂运动看门狗、
    把 failsafe_latched(flags bit1 看门狗停车)清掉、然后按 20ms 周期发 CTRL_BRAKE。
    所以显式零速和静默 800ms 在电机上一样(都刹车), 语义完全不同:
    显式零速清锁存, 静默置锁存并锁住 + 断开继电器。想按住车就持续发零速。
    零速帧字节: 7B 00 00 00 00 00 00 00 00 7B 7D (BCC 恰好等于帧头)。
    顺手查出一个以前没记录的坑, 已写进 chassis-serial-protocol.md 6.3.1:
    厂商节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
2026-10-10 fix(tools): field_diag.sh 的 set -u 会把脚本直接打死; 加 zero_stop_probe.sh 定位"发0不停车"
    ## 1. field_diag.sh 是坏的 (我自己写的, 只跑过 bash -n 没真跑过)
    它开头有 `set -u`, 而 ROS 的 setup.bash 第 8 行引用了未绑定的
    AMENT_TRACE_SETUP_FILES —— 在 set -u 下 `source` 会把整个脚本打死。
    症状是"一条输出都没有, 退出码 1", 而且因为 stdout 重定向到管道时是块缓冲,
    连第一行 echo 都看不到, 极难查。
    ★ 这个坑本仓库已经踩过三次并写进了注释:
    chassis_bringup.sh:15 / chassis_watchdog.sh:44 / chassis_web.sh:8 都明确写着
    "不要加 set -u (nounset)"。2026-10 我又踩了一次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
2026-10-10 docs(nav2): §5.1 "发 0 速停不下来" —— /cmd_vel 有 5 个发布者且没有仲裁
    上一提交把这条写进去了但提交信息没描述, 这里补上, 并标出一处"推断 vs 实测"。
    实测到的(有命令输出/源码为证):
    - /cmd_vel: Publisher count 5, Subscription count 1(只有 wheeltec_robot)
    behavior_server ×3, stop_all_services ×1, controller_server ×1
    —— `ros2 topic info -v /cmd_vel`, 2026-10-10 17:1x
    - 没有活跃 goal 时, 20 秒内一条 /cmd_vel 都没有(所以车停着)
    - /wheeltec_robot 确实订阅了 /cmd_vel (RELIABLE)。更早一次读到
    "Subscription count: 0" 是**图的瞬时假象** —— 板子 load 8+, ROS 图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
2026-10-10 feat(tools): cmd_vel_guard.py —— 可靠停车 /chassis_stop, 不用改同事的 Nav2 配置
    ## 背景(用户确认: 是"后者")
    同事是**直接 `ros2 topic pub` 往 /cmd_vel 发 0**, 不是走 /ly_nav/stop_all。
    那就是**一帧** 0, 而 controller_server 正按 controller_frequency 持续发非零,
    50~100ms 内就被覆盖 —— 一帧 0 在原理上不可能停车。
    链路已查清: /cmd_vel 一个订阅者(wheeltec_robot) + 5 个发布者
    (controller_server / behavior_server ×3 / stop_all_services), **没有仲裁**,
    也没装 twist_mux。本车 controller_server 里加载的是自定义插件
    **sweeper_stanley_controller**(LY_sweep_ws/LY_sweeper/nav2_stanley_controller,
    Sta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
2026-10-10 docs(nav2): 更正 §5.1 —— "发 0 车不停"的真因是执行侧没有保持力, 不是 /cmd_vel 仲裁
    用户指出我诊断错了: 问题不是"从外面发一帧 0 被盖掉", 而是
    **sweeper_stanley_controller 自己发 0 的时候车也不停**。我去读了那个插件,
    确认它发的是干净的 0 —— stopCommand() 返回 TwistStamped,
    twist.linear.x = 0.0; twist.angular.z = 0.0; (holdCommand 也是转调它)。
    所以命令侧没问题, 用户是对的。
    真因在底盘侧, 而且我们自己的注释和 README 早就写了:
    main.c 里 #define STOP_CTRL CTRL_BRAKE, 而 CTRL_BRAKE(0x03) 是**动态制动
    (相线短接)**: 制动力与转速成正比, 静止时接近 0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
2026-10-11 feat(firmware): 支持第二个车型(洗地机 150mm/425mm) —— 编译期选车型, 选错就编译失败
    底盘控制两辆车完全一样, 只有几何不同, 所以做成一份源码 + 编译期选车型:
    VEHICLE_SWEEPER 扫地机 205mm / 930mm (PB9 灯 2Hz)
    VEHICLE_SCRUBBER 洗地机 150mm / 425mm (PB9 灯 5Hz)
    默认 VEHICLE_SEL = VEHICLE_SCRUBBER(当前在调的车)。
    ## 为什么这不是"改两个数字"那么随便
    选错车型是**安全级**错误, 不是"精度差一点": 固件按 track 算轮速
    (ω = wz × (track/2)/周长 × 60), 所以
    wz_实际/wz_命令 = track_假设/track_真实
    把扫地机固件(930)烧到洗地机(425)上 -> 转向增益 **2.19 倍**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
2026-10-11 feat(build): Keil 加两个 target(sweeper/scrubber) —— 选 target 就是选车型, hex 文件名自带车型
    用户问"我该怎么选择能烧录什么固件"。原来的做法(改源码里的 VEHICLE_SEL 再编译)
    有个真隐患: **两个车型产出的 hex 文件名完全一样**(都是 stm32-chassis.hex),
    编完就分不清哪个是哪个 —— 而几何选错是安全级错误(转向增益差 2.19 倍),
    不能靠"我记得刚才改过"。
    所以给工程加两个 target:
    | target | 车型 | 几何 | PB9灯 | hex |
    |-----------|--------|-------------|-------|----------------------|
    | sweeper | 扫地机 | 205/930 mm | 2 Hz | Objects/sweepe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
2026-10-11 feat(firmware): 上电自检点动 —— 上电延迟 3 秒后往前动一下(约 7~16cm)
    需求: "上电时前进10cm" + "上电后延迟三秒再走"。确认过用途是**自检**(证明
    驱动器/CAN/电机/接线方向都是好的), 精度不敏感, 放 STM32 上(不依赖上位机)。
    ## 为什么不做成"真正的 10cm"
    本车停车靠 CTRL_BRAKE 动态制动, 制动力 ∝ 转速 -> **没有保持力**; 扫地机实测
    停车后滑约 12cm。按 距离 = v0 × τ 反推(12cm @ 0.30m/s -> τ≈0.4s):
    扫地机 最低可控 0.22 m/s -> 该速度下就要滑 ~9cm
    洗地机 最低可控 0.12 m/s -> 推算滑 ~5cm(未实测)
    也就是**最慢能控的速度本身就要滑掉和目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
2026-10-11 docs+tool: 说清"芯片 ID"(USB VID:PID) 与 CH340 的两个隐患
    同事提的"芯片 ID"就是 USB 的 VID:PID。实测本车底盘适配器:
    Bus 001 Device 002: ID 1a86:7523 QinHeng Electronics CH340
    ID_VENDOR_ID=1a86 ID_MODEL_ID=7523
    ID_SERIAL=1a86_USB_Serial <- ★ 普通 CH340 没有唯一序列号, 所有 CH340 都是这个串
    物理口 DEVPATH=.../usb1/1-1/1-1:1.0 -> KERNELS=="1-1"
    这解释了为什么必须自己写 udev 规则: 厂商那套规则是靠**序列号**认设备的
    (CP2102 10c4:ea60 / CH343 1a86:55d4, serial 0001~0005), 而 CH340 没有序列号,
    按 serial 匹配根本匹配不上。README 里那张对照表把这个写清楚了。
    ## 顺手查出两个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
2026-10-11 docs+tool: "要不要换 CH343 + 自定义 ID" —— 实测本车内核不认 CH343, 现在换直接不能用
    同事一直建议换 CH343 并烧自定义序列号。核实后的结论: **方向是对的, 但本车现在换不了。**
    ## 决定性证据(实测)
    ch341.ko 的 alias 一共 6 个, **没有 55d4**:
    v1A86p7523 / v1A86p7522 / v1A86p5523 / v9986p7523 / v4348p5523 / v2184p0057
    /lib/modules/6.1.118 里只有 ch341.ko, **没有 ch343.ko**, 没有 dkms, /usr/src 里也没有 WCH 源码
    当前 tty 只有 /dev/ttyUSB10 (没有 ttyCH343USB*, 没有 ttyACM*)
    -> 内核自带的 ch341 **不认 CH343**, 也没装 WCH 的 out-of-tree 驱动。
    现在插 CH343 上去根本不会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
2026-10-11 docs: 新增 foc-can-protocol.md —— FOC 驱动器 CAN 协议, 经厂家资料核实
    用户拿到了电机厂家的参考资料包(已由用户改名为 .doc/), 要求先学习、整理成文档, 并
    把 .doc 加进 gitignore。
    ## .gitignore
    加 .doc/ (只匹配目录, 不会误伤 Word 的 .doc 文件)。写清了为什么忽略(2370 文件 /
    617 MB, 大部分是编译产物)、以及**为什么不建议删**: 新文档里引用了它的具体
    文件:行号, 删了就没法再核对, 换机器要单独拷过去。
    已验证: git check-ignore 命中 .doc/ 和 .doc/ 里的文件, git status 看不到它。
    ## 新文档 docs/foc-can-protocol.md
    定位: **STM32 ↔ FOC 驱动器 (CAN)**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
2026-10-12 fix(keil): 两个 target 共用输出目录 -> 选 sweeper 却烧成洗地机固件
    用户报告: target 选的是 sweeper, 但 PB9 灯闪得很快(5Hz 而不是 2Hz), 同事反馈导航不对。
    **用户判断正确, 固件确实烧错了** —— 而且是我加双 target 时引入的。
    ## 根因
    用文本复制 <Target> 块的方式加 target, 把原来的 <OutputDirectory>.\Objects\</OutputDirectory>
    一起复制了过去 => **两个 target 共用同一个输出目录**, 而 .o 按源文件名命名 =>
    **全工程只有一个 main.o**。于是:
    选 scrubber -> F7 编译 -> main.o 是【洗地机】版
    选 sweeper -> F7 增量编译 -> Keil 见 main.c 比 main.o 旧,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
2026-10-12 tools: 修掉 add_keil_targets.py 文档字符串里的无效转义警告(改为 raw string)
2026-10-12 feat(torque): 力矩模式实验 —— STM32 自己用扭矩做速度环(DRIVE_MODE_SEL)
    新建 torque-mode 分支。起因: 实测驱动器**内部速度环**有极限环 —— 目标 27.9 RPM,
    实际在 0↔71 RPM 之间暴力来回冲、电流 7~11A; 我们的外环只贡献几个 RPM, 够不着。
    而协议**不暴露任何参数读写**, 我们调不了那个环 —— 只剩"找厂家"或"自己做速度环"。
    2026-10-11 用厂家资料确认了**扭矩模式 0x04 确实存在**(单位 A, 量程 ±10.0A,
    值 = 电流x10; 我们以前判断"0x04 不存在"是错的), 所以第二条路通了。
    ## 做法
    加 DRIVE_MODE_SEL 编译开关(sweeper/scrubber 两个 target 都适用):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
2026-10-12 tune(torque): 限流 3A->8A —— 台架实测 3A 完全推不动, 依据是"正常行驶要 7~11A"
    洗地机第一次台架实测(--drive 0.05 0, 2 秒, TQ_MAX_A10=30):
    ✅ **扭矩链路整条是通的** —— 这是本次最有价值的结论:
    驱动器回码 模式=力矩(吃下了 mode 4, 第一次实证)
    电流跟着我们的爬升逻辑走 0.1->2.5A(指令真的到了电机)
    flags bit6 亮(扭矩环在出力), can_err=0 坏帧=0 溢出=0 故障正常
    ❌ **但车完全没动**:
    实际转速全程几乎 +0; IMU 加速度峰峰值 x/y/z = 0.01/0.01/0.03 m/s2
    (独立于轮速的裁判: 车一点没窜)
    电流爬到 2.5A(限流 3.0A)
    ## 故障定位: 限流太低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
2026-10-12 fix(firmware): 自检开关用在了 DRIVE_MODE_SEL 定义之前 -> #if 恒真 -> 自检被静默关掉
    用户要求先存一份当前代码。
    ## bug
    上一版把"力矩模式下关掉上电自检"写成了:
    #if DRIVE_MODE_SEL == DRIVE_MODE_TORQUE
    #define SELFTEST_ENABLE 0
    #else
    #define SELFTEST_ENABLE 1
    #endif
    但这一段被放在**自检那段注释下面(文件靠前)**, 而 DRIVE_MODE_SEL 定义在**更后面**。
    C 预处理器对未定义标识符按 0 处理, 于是 `0 == 0` **恒真** -> SELFTEST_ENABLE
    **在两种模式下都是 0** -> 上电自检点动在这条分支上**整个是死的**。
    症状极隐蔽: 编译 0 Error 0 Warning, 只是速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
2026-10-12 feat(trim): 助推拆成独立开关 KICK_ENABLE; 修 decode_diag 的车型几何 bug
    用户要求先提交代码。
    ## 1. KICK_ENABLE: 助推从 TRIM_ENABLE 里拆出来
    以前"关助推"必须连稳态修正(Trim)一起关掉。现在独立开关, 默认还是 1(保持现状)。
    背景(已写进 main.c 注释): 起步助推(KICK)是**两轮共享**的加性大增量, 一个轮子
    没转起来就把两个命令一起顶高十几~二十 RPM, 于是另一个轮子必然超速。
    ★ 为什么默认值保持 1 —— 实测**推翻了**"助推有害":
    洗地机 0.2 m/s(目标 25 RPM), 每种配置跑 **4 次**, 取后 1/3 的**均值**:
    Trim开+助推开 : 左 中位 98% 右 中位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
2026-10-13 feat(trim): 外环"误差门限"改成"误差低通" —— 修"走不直"这条链上唯一属于我们的原因
    ⚠ 本提交**尚未在车上实测**(改完去测时发现驱动器供电没了: can_err=255 +
    驱动器未就绪, CAN 总线无应答)。逻辑与编译已验证, 效果待台架确认。
    ## 问题(实测证据)
    `Trim_Apply` 里原有一条: 只有 |误差| < TRIM_LIN_BAND_RPM(=5 RPM) 才积分。
    当初加它是为了不让外环和驱动器 PI 组成 0.25Hz 极限环。
    但它**把外环废掉了**:
    驱动器速度环的振荡幅度是 ±15 RPM(目标 38, 实际在 23~52 之间摆, 峰值到过 218),
    远大于 5 RPM -> 积分窗几乎不打开; 就算打开, 窗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
2026-10-13 feat(yaw): 加 IMU 偏航外环(闭在陀螺仪上, 不闭在轮速上)
    ⚠ 符号已经在车上验证(相关系数 −0.81, 它在对抗偏航而不是放大);
    **但"能不能让车走直"没能验证** —— 因为抓到了硬件故障, 见下。效果待硬件修好后重测。
    ## 为什么轮速外环解决不了"走直"(实测)
    0.3 m/s 直行, 每米偏航(IMU 积分/轮速里程):
    轮速外环 门限版: 8.27 deg/m 轮速外环 低通版: 10.67 deg/m
    (低通版确实起作用了: 外环目标差 0.00 -> 1.42 RPM, 机制成立, 但结果没改善)
    对不上的地方:
    用轮速差推出来的偏航 2.4~3.6 deg/m
    IMU 实测 8.3~10.7 deg/m <-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
2026-10-13 refactor(yaw): 航向 PI 环 -> 偏航失控制动。★主机侧本来就有航向环, 底盘不该再抢
    ## 推翻上一版: 航向环在架构上是错的
    上一版(a249a3f)在固件里加了一个 IMU 航向 PI 环。本轮在车上翻到主机侧**早就有一个**:
    ~/wheeltec/src/straight_line_drive/ (ROS2 action: /drive_straight)
    config/params.yaml:
    "DJI-gimbal style: lock heading; tiny path nudge (des <= 2.5deg)"
    odom_topic: /odom imu_topic: /imu/data_raw cmd_vel_topic: /cmd_vel
    yaw_kp: 1.40 max_yaw_rate: 0.08 control_sign: 1.0
    wz_ff: -0.013 ff_adapt_gain: 0.10 ff_adapt_limit: 0.012
    yaw_des_max_deg: 2.5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
2026-10-13 feat(tools): decode_diag 加"测试有效性判定" —— 堵转/偏航失控实时识别并自动停车
    ## 为什么必须做这个
    之前所有"走直/转准"的测试都被同一个问题污染: **车到底有没有顶到东西?**
    实测出现过"轮子 0 RPM 却吃 20~43A", 这个特征有两个同样成立的解释:
    (a) 驱动器/相线故障 (b) 轮子被顶住了(车头顶到墙 -> 该轮堵转)
    分不清这两者, 任何结论都不成立 —— 我为此已经收回过一次"硬件故障"的判断。
    所以把它变成**可判定、且自动终止**的。
    ## 判据
    堵转: |目标| >= 20 RPM 且 |实际| < 5 RPM 且 |电流| >= 2.0A, 持续 >= 400ms
    失控: |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
2026-10-13 docs: ★新增「谁该干什么」—— STM32 与 RK3588 的责任边界
    用户要求把分工讲清楚("越详细越好")。动手前先读了已有的 docs/ros-integration.md
    (376 行), 发现**很多我这轮在重推的结论那里早就记下来了** —— 所以这次不是重复劳动,
    而是把已有结论 + 本轮新发现串成一份**责任边界**文档, 并在两边互相交叉引用。
    ## 为什么需要单独一份
    ros-integration.md 是**接入指南**(怎么启、实测过什么)。这次缺的是**边界契约**:
    每件事该谁做、各自绝对不能做什么。起因就是 2026-10-13 那次真实冲突 ——
    底盘里加了一个"用 IMU 保持航向"的控制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
2026-10-13 docs(labor): 分工细化到「逐函数 / 逐节点」; 并更正一处我写错的关键事实
    用户要求"详细到每个小功能"。§3 现在覆盖固件里**全部 45 个函数**(带行号),
    §4 覆盖 RK3588 的**逐个节点**。另外读到代码后发现上一版有一处**事实错误**, 一并更正。
    ## ★★ 关键更正: 里程刻度在底盘侧, 不在主机侧
    上一版我写"轮速→(vx,wz) 正解只进诊断帧、不发给主机" —— **错的**。
    实际: `Send_MainTelemetry` 把**固件自己算出来的** body_vx/body_wz 填进 24 字节
    厂商主遥测帧的 [2-3]/[4-5]/[6-7]。**而这个帧里根本没有"左右轮速"字段** —— 厂商
    节点拿到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
2026-10-13 feat(stable): main 定成"速度模式稳定版" —— 32 做减法 + 多向上位机报数据
    用户 2026-10-13 定调: **航向保持交给 RK3588**, 底盘只当"忠实的速度执行器"。
    本提交在合并 torque-mode 之后, 把 main 收成一个稳定版本。
    ## 1. 三个开关的默认值(这就是"做减法")
    DRIVE_MODE_SEL = SPEED (合并前分支上是 TORQUE)
    SELFTEST_ENABLE = 0 (原来是"速度模式 1 / 力矩模式 0")
    YAW_ARREST_ENABLE= 0 (原来是 1)
    理由:
    - **DRIVE_MODE_SEL 默认速度模式**: 速度模式是已验证能跑的那条路(扫地机 0.30 m/s
    跟踪 103%、漂移 -3.2°/m), 力矩模式至今没跑通。正常运行编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
2026-10-13 docs(labor): §8.10 把 44 字节诊断帧接到 ROS 侧 —— 只剩主机侧补丁
    固件侧已完成(29e3fd9): 诊断帧 36->44 字节, 加了饱和/保护标志、底盘时基、
    "底盘收到的指令"。**但厂商节点按设计把整帧跳过**, 所以数据到不了 ROS 侧。
    本提交把剩下的主机侧工作写成明确待办(位置已从源码查到):
    wheeltec_robot.h RECEIVE_DATA_SIZE 24 附近 -> 加 DIAG_FRAME_SIZE 44 + 新 publisher
    wheeltec_robot.cpp 收帧解析(约 L750) -> 显式识别 0x7E 帧并 publish
    关键: 厂商入帧条件是"上一字节 0x7D + 本字节 0x7B", 诊断帧头是 0x7E, 所以现在是
    整帧跳过 —— 显式识别只是接管本来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
2026-10-13 docs(labor): §8.10 挪到 §8.9 之后(编号顺序)
2026-10-13 fix(tools): 修两个自己的 bug —— 格式化参数少一个 + os._exit 吞掉 traceback
    在车上验证新固件(44 字节诊断帧)时踩到的, 而且**第二个 bug 一直在掩盖真故障**。
    ## 1. line() 少了一个格式化参数 -> TypeError
    加"rxcmd/tick"显示时把格式串写成 7 个 %s, 但参数只传了 6 个(最后一个是
    drive_text+sat_text 拼好的一个串)。症状: 工具**零输出、退出码 0**。
    ## 2. ★ os._exit(0) 会把 traceback 一起吞掉
    finally 里有 os._exit(0), 它会**跳过解释器打印 traceback**。于是上面那个 TypeError
    表现成"一帧都没收到" —— 我为此先怀疑串口、再怀疑固件、再怀疑帧长,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
2026-10-13 fix(control): 治"顶不动就猛冲" —— 助推收手 + 外环不再对被顶住的轮子攒积分
    ## 起因(架空 + 手按住左轮的实测)
    命令只左轮 25 RPM, 用户用手按住:
    时间 | 目标 实际 电流
    1.0s | +38 +0 +8.70A <- 目标被顶到 38(命令只有 25)
    7.5s | +26 +0 +4.00A
    松手瞬间: **实际冲到 122 RPM**(目标的 5 倍)
    拆开那 +17 RPM: 助推 +20 封顶, 外环 Trim +20%(=+5)。
    => **两者都在"轮子不动"时往上加 -> 驱动器收到的目标比命令高 68% ->
    它内部速度环的积分被喂到饱和 -> 负载一消失就全部释放 = 猛冲。**
    关键认识: 助推的设计目标是破**静摩擦*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
2026-10-13 feat(diag): 驱动器"不给力"检测上报 + 复位命令 —— 查明并回答长期悬案
    ## 查明的现象(地面右轮, 实测)
    目标 +54 RPM | 实际 0 | 电流 -0.3~+4.6A | 故障码"正常" | 模式"速度"
    电池 40.7V 纹丝不动(同一时刻左轮在吃 17.5A) can_err=0
    判据链:
    电流小(0~4.6A) -> 不是"顶不动"(那要 12~17A), 是驱动器**没在执行**
    can_err=0 -> CAN 广播+应答, 收不到就不会 ACK => **命令确实到了**
    电池不塌 -> 不是电源
    故障码正常/模式速度 -> 驱动器自认为没问题
    **整车断电重启 -> 立刻恢复(连续 3 遍两轮全工作)** => **锁存状态, 不是硬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
2026-10-13 feat(torque): 新分支 torque-mode-v2 —— 力矩模式落地第一步: 开环定电流测试开关
    ## 为什么新开分支
    main 已经有全部近期修复(治猛冲、驱动器"不给力"上报、复位命令), 而以 |main 为基线
    重做力矩模式, 不去动历史那个旧的 torque-mode 分支。
    ## 这一版的改动: `TQ_OPENLOOP_A10`
    力矩模式**从没跑通过**。而在调那个 PI 之前, 必须先单独验证三件和 PI 毫无关系的事 ——
    任何一条不对, 调参都是白费, 而且调不出来还查不出原因:
    ① **方向**: 命令正电流, 轮子真的往"前进方向"转吗?
    速度模式下的正方向已经实测验过(架空跟踪 100%);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
2026-10-13 feat(torque): 力矩模式第一次跑起来 —— 三个真 bug 修掉 + 电流终于到 12A
    ## 起点: 力矩模式从没跑通过
    新版从 main 拉分支 torque-mode-v2, 先在架空条件下把三件**和 PI 无关**的基础事实验掉
    (新增 TQ_OPENLOOP_A10 固定电流 / TQ_OPENLOOP_GAIN_M 扫电流两个台架开关):
    ① 方向 ✓ 命令正电流, 两轮都往"前进方向"转
    ② 量纲 ✓ 回码电流与命令吻合(2号要取反是 MOTOR2_INVERT, 合理)
    ③ mode4 ✓ 驱动器回码模式就是"力矩"
    ★ 顺带否掉了"换相不对/扭矩利用率低"的怀疑 —— 实测 1.5A 就能把架空轮子推到 62 RPM
    ## 修掉的三个真 bug
    1. **起步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
2026-10-13 feat(torque): ESP32-S3 裸 CAN 判决实验固件 —— 把 STM32 固件彻底排除
    ## 为什么要有它
    STM32 固件里叠了七八层逻辑:
    逆解 -> 起步下限 floor -> PI -> 防打滑 -> 限幅 -> Torque_Guard(三条保护)
    所以一直有个可能性排除不掉: **"是不是我们自己这些层把命令改坏了"**。
    (成帧已经和厂商参考 .doc\FOC_APP\MainWindow.xaml.cs + ESP_CAN_2.1\main\pwm_adc.c
    逐字节核对一致, 但那只是成帧, 不代表整条链路。)
    这个固件**只发原始命令**, 一个字节都不加工:
    ESP32 发 12A 车不动 -> 彻底排除我们的固件, 是驱动器/mode 4 的问题
    ESP32 发 12A 车能走 -> 我们的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
2026-10-13 feat(esp32): 判决实验固件改成"地面安全版" —— 力矩档必须手动解锁
    ## 实测背景(决定了这个改动)
    第一次跑(EPS32-S3 裸 CAN, 车架空)拿到两份关键数据:
    ② mode5 速度 38RPM: M1 +38 / M2 +38 精确跟踪, 电流只 ±0.3A -> **速度模式完美**
    ③ mode4 力矩 2.0A : M1 +489 / M2 +514 RPM -> **空转飞车!**
    => **力矩模式是纯扭矩、没有任何速度限制**: 空载 2A 就能一路加速到 489RPM(3.8m/s)。
    这正是我们 STM32 固件里加 floor/guard/slip 一堆保护的原因, 也是地面上不能随便跑的原因。
    ## 改动
    1. **③ 力矩阶梯不再自动跑** —— 停在 PH_WAIT 等串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
2026-10-13 fix(esp32): 修编译错误 —— g_arm_torque 声明在 poll_serial() 之后
    poll_serial() 在 L63 就用了 g_arm_torque, 而它声明在状态机那段(L185),
    C++ 里先用后声明 -> "error: 'g_arm_torque' was not declared in this scope"。
    把声明提到文件上方(g_stop 旁边), 状态机那段只留注释指路。
    我的顺序错误, 和逻辑无关。
2026-10-13 feat(esp32): CAN 调试网页 —— 手动调力矩电流(0~10.0A) / 速度, 带三道安全闸
    ## 为什么做这个
    厂商确认: **力矩模式上限 10.0A** (和我们从 esp_my.h 读到的 max_A=100 一致)。
    要回答"这台车到底需要多少电流才推得动", 最直接的办法是**手动一点点加、同时看轮子**。
    ESP32-S3 起一个 WiFi 热点 + 网页, 手机/电脑连上就能拖滑块, 不用装任何东西。
    ## 三道安全闸(都不是可选项 —— 力矩模式没有速度闭环)
    ① 值域硬夹: 力矩 <= 100 (=10.0A, 厂商上限); 速度 <= 500 RPM
    ② 超速保护: 任一实际转速 |RPM| > 150 -> 立刻刹车并**锁存**, 网页红字报告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
2026-10-13 feat(esp32): 安全诊断固件 —— 查"另一个轮子 + 两个驱动器"坏没坏
    ## 前提: 已经有一个轮子烧坏了
    所以这个程序**只有一个目的: 用最小的电应力把好/坏区分开**。
    它不是性能测试, 不是调参工具。
    ## 三条硬设计原则(都是为了不再烧电机)
    ① **单轮测**: 一次只让一个轮子动, 另一个发刹车。坏的那侧不会被另一个
    拖着转, 而且能干净地分清"是哪一侧的问题"。
    ② **极低速 + 短时**: 目标 15 RPM(150mm轮=0.12m/s), 每项 **2 秒**, 项间冷却 3 秒。
    架空时这个负载只需要约 0.3A。
    ③ **异常立刻自停**: 每 20ms 检查 —— "电流>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
2026-10-13 fix(esp32): 我上一版漏了 Bus-Off 处理 —— 补上, 并做"链路诊断"版把代码/硬件分开
    ## 我代码里的真问题(用户质疑后查出来的)
    esp32_can_check 里**没有处理 TWAI 的 Bus-Off**:
    TX 失败(总线没人 ACK)时硬件自动重传 -> 错误计数累积 -> 进 Error-Passive
    -> 再严重进 **Bus-Off = 控制器彻底停止收发**, 而且必须主动恢复
    (twai_initiate_recovery)或重新初始化。我的代码没做 -> "发不出去"被表现成
    "什么都没有", 看起来像死机。
    ★ 修复: 检测到 BUS_OFF 就主动发起恢复, 并把 TWAI 内部状态打出来。
    ★ 但要澄清: 这**不会**"让 CAN 通讯有问题" —— 它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
2026-10-14 feat(esp32): 驱动器**串口**探活固件 —— 独立于 CAN 的另一条路
    ## 为什么做
    CAN 那边两个主控(ESP32 和 STM32)都读到"驱动器完全不回应":
    STM32: can_err=255 饱和, 驱动器未就绪, 诊断帧里连 bat= 都没有(说明 E603 也没来)
    ESP32: 发送 346 次失败, 总线错误 15993, 一次 ACK 都没有
    但厂商文档 2.2 节说明驱动器**同时支持串口**。所以这是条独立的路:
    串口能通 -> 驱动器活着, 问题在 CAN 那一侧/驱动器 CAN 部分
    串口也不通 -> 驱动器没电/没接/已损坏
    ## 这个固件默认**只听, 什么都不发**(零风险)
    驱动器有电就会每约 5 秒主动发一次 E603 上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
2026-10-14 fix(esp32): 串口探活改用 GPIO4/5 —— 用户的板子引不出 17/18
    用户反馈 ESP32-S3 板子上没有 17/18 这两个脚。改用 GPIO4/5 —— 和之前 CAN 测试
    用的是**同一对脚**, 既然 CAN 那时能收 104 帧回码, 说明这对脚一定引出来了。
    同时在注释里列出 ESP32-S3 上**安全可用**的脚和要避开的:
    可用: 1~18, 21, 38~42, 47, 48
    避开: 0/3/45/46 strapping; 19/20 USB; 26~37 SPI Flash/八线 PSRAM
    (这块是 8MB 内嵌 PSRAM, 26~37 多半被占)
2026-10-14 feat(esp32): 串口**主动查询**固件 —— 实测驱动器不主动上报, 所以改成发一帧看它回不回
    用户反馈: "只听"那一版收不到任何东西, 驱动器好像不会主动发。
    (厂商文档说 E603 默认 0.2Hz 上报, 但实测没有。) 所以改成主动发。
    ## 安全: 只发两种帧, 电机不可能转
    ① 速度模式(05) + 使能(01) + 值=0 -> 目标转速 0 = 不动
    ② 刹车帧(03)
    **绝对不会发任何非零设定值。**
    ## 帧格式(厂商文档 2.2)
    115200 8-N-1, 最小间隔 5ms
    FA + 4字节ID + 8字节数据 + AF (14 字节)
    ID: 1号 11 01 E6 00 / 2号 12 01 E6 00; 回码末字节 01, 上报末字节 03
    ## 做什么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
2026-10-14 feat(esp32): CAN **总线探测器**(sniffer) —— 只听不发, 可和 STM32 同挂一条总线
    ## 用途
    用户准备把 ESP32 和 STM32 都挂在一条 CAN 总线上测。但两个主控**都发**会有问题:
    驱动器收到谁的命令不确定。所以需要一个"只听"的工具。
    这个固件**一个字节都不发**(源码里没有任何 twai_transmit), 只把经过总线的
    **每一帧(任何 ID)**打印出来并统计各 ID 帧数。因为没有 TX, 它不参与仲裁、
    不抢总线、不影响任何东西 —— 可以安全地和 STM32 同挂。
    ## 怎么用它定位
    总线一片安静 -> 没节点在工作(供电/接线/收发器/波特率)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
